yuiseki/exp-dodeca-earth/firmware/hub6_bench/README.md

# hub6_bench

XIAO ESP32-S3 1 枚と 74HC138 で、1.28 インチ丸型 LCD (GC9A01、Waveshare 1.28inch LCD Module) 6 枚を駆動するスケッチ。既定では、発注した基板 hub6_one (`hardware/hub6_one`) のピンの割り当てでビルドする。基板を発注する前に 6 枚を駆動できるかを確かめたブレッドボード (ピンの割り当ては hub6 の README と同じ) 用には、`HUB6_BREADBOARD` を定義してビルドする (下の「ビルドと書き込み」)。

## ビルドと書き込み

地球の画像 `earth_faces.h` は生成物で、git には入れていない。先に作る。元の画像は正距円筒の全球画像なら何でもよい。NASA Blue Marble 2002 (パブリックドメイン、exp-cubic-earth にある) なら:

```sh
../../.venv/bin/python make_earth_faces.py ../../../exp-cubic-earth/lt7680_earth/blue_marble_2002.jpg --preview earth.png
```

どのディスプレイがどの板に載っているかは `--board` で選ぶ。既定の `hub6_one` は、XIAO をお椀の口の側に向けて基板を裏返して使う置き方で、ケーブルの列が板に鏡の順で届く。底の外から見て P1〜P5 が反時計回りに並び、BASE の画面の上が P2 を向く (2026-11-05 に実物で確認)。`--board model` は 3D モデルの番号どおり (`make_earth_faces.py` の `PLACEMENT`)。

自前のタイルサーバーの地図 (Web メルカトルのラスタータイル) なら、ズーム 4 の 256 枚をつないで正距円筒に直してから使う。北緯 85 度より北と南緯 85 度より南はタイルに無いので、85 度の行の色を引き伸ばす:

```sh
../../.venv/bin/python make_tile_mosaic.py https://tile.yuiseki.net/styles/osm-liberty-no-text-no-icons --zoom 4 --cache ../../tmp/tiles --out ../../tmp/osm-liberty-equirect.png
../../.venv/bin/python make_earth_faces.py ../../tmp/osm-liberty-equirect.png --preview earth.png
```

そのあと、無線 (ESP-NOW) を使うなら `secrets.h` を作る。中身は exp-cubic-earth の `espnow_bridge/secrets.h` と同じ AP の並びにする (`secrets.h.example`、git には入れない)。無ければ AP にはつながず、ESP-NOW はチャンネル 1 で待つ:

```sh
cp ../../../exp-cubic-earth/espnow_bridge/secrets.h secrets.h
```

hub6_one rev E (草案) の基板には `--build-property "compiler.cpp.extra_flags=-DHUB6_ONE_REV_E"` を付けてビルドする。A0〜A2 のピン (D8、D9、D10) と、画面ごとのアドレスが rev D と違う。

テストは `../../.venv/bin/python -m pytest -q test_make_earth_faces.py test_board_matches_firmware.py` (後者は rev E の表が `hardware/hub6_one/make.py` と一致するか) と `g++ -std=c++17 -Wall -Wextra -I. test/test_espnow_cmd.cpp -o /tmp/t && /tmp/t` (`test_wifi_status.cpp`、`test_web_face.cpp` も同じ形で)。ビルドには PSRAM (`PSRAM=opi`) と、ライブラリ JPEGDEC (`arduino-cli lib install JPEGDEC`) が要る (`j` が PSRAM に 6 面を置き、JPEG を展開する)。

```sh
arduino-cli compile --fqbn esp32:esp32:XIAO_ESP32S3:PSRAM=opi --output-dir build .
arduino-cli upload --fqbn esp32:esp32:XIAO_ESP32S3:PSRAM=opi --input-dir build -p /dev/ttyACM0   # ポートは arduino-cli board list で
```

ブレッドボード用は、compile に `--build-property "compiler.cpp.extra_flags=-DHUB6_BREADBOARD"` を足す。

ライブラリは M5GFX (0.2.32 で確認。中の LovyanGFX の `Panel_GC9A01` を使う)。ESP32 の Arduino core は 3.3.12 で確認。

## 無線 (ESP-NOW)

母艦などに挿した exp-cubic-earth の `espnow_bridge` から、シリアルと同じ命令を送れる。起動して番号の画面を出したあと、`secrets.h` の AP (pi5-w-1 が先頭) につなぎ、ESP-NOW をその AP のチャンネルに相乗りさせる。中継も同じ並びで同じ AP につなぐので、チャンネルがそろう。起動のログに `wifi: pi5-w-1, channel 6` と `espnow: <MAC>, channel 6 (the AP's)` が出る。

中継に送る行と、受けるもの:

- `!E8:F6:0A:8D:28:D8 e`: この XIAO だけに送る。行全体を命令として受ける。ACK が返る
- `@dodeca e`: 全員に送る。正十二面体は `@dodeca ` のあとを命令として受ける
- `#b` などの四角い地球の命令: 全員に届くが、正十二面体は受けない。`#b` の `b` や `#f…` の `f` を自分の命令と取り違えないため (`espnow_cmd.h`)

命令の出力は、USB のシリアルに出すのに加えて、送り主にだけ 1 行ずつ返す。中継には `rx <MAC>: earth` のように出る。全員には送らない。

AP を待つのは 15 秒。pi5-w-1 は、鍵の交換から 3 秒後に IP を渡したことがあり、中継と同じ 8 秒では、その直前で諦めていた (2026-11-05)。

XIAO ESP32-S3 には基板のアンテナが無く、U.FL のアンテナを挿して使う。挿し忘れても ESP-NOW は近くならときどき届くので、気づきにくい。そのときのログは、スキャンで見える AP が 2〜4 個 (アンテナありなら 15 個ほど)、`wifi: joining pi5-w-1 (rssi 0 ...)` か `wifi: disconnected, reason 2` (認証の応答が来ない) の繰り返し、`wifi: no AP from secrets.h joined`。アンテナを挿すと rssi -60 前後でつながった (2026-11-05)。

AP につながらないあいだも、Wi-Fi は裏でつなぎ直そうとし続け、チャンネルを AP のもの (pi5-w-1 なら 6) に戻す。そのため `ESPNOW_CHANNEL` に合わせたつもりでも合っていないことがある。いまのチャンネルは `w` で聞ける (`wifi: no AP, channel 6 (asked for 1)`)。

## microSD (Sense の拡張基板)

カードの SCK、MISO、MOSI は D8、D9、D10 で、お椀の基板では 74HC138 の A2、A1、A0 と同じピン。CS だけ GPIO21 (拡張基板の R12)。四角い地球 (exp-cubic-earth) はこの 3 本を LT7680 と SPI のまま共有できるが、お椀ではアドレス線なので、カードに触るあいだだけ SPI に切り替え、終わったらアドレス出力に戻す (`cardTest`)。カードの通信中はアドレスが動いて、どれかの画面の CS が下がるが、画面の CLK (D4) と DIN (D5) は止まっているので何も書き込まれない、という見立て。カードは SPI3 (HSPI)、画面は SPI2。

カードなしで `c` を送ると `mount failed` が返り、そのあとも画面の命令は普通に通る (2026-11-07)。カードを入れると読み書きできた: 29.5GB の SDHC、115200 バイト (画面 1 枚ぶん) の書き込み 139 ms と読み 126 ms (10MHz)、90 ms と 79 ms (20MHz)、化けは 0 バイト。そのあとの `e` も通った (画面の見た目は未確認)。

## Web の地球 (`j`)

exp-cubic-earth の `#j` と同じく、Web サーバーに置いた JPEG を Wi-Fi で取って描く。microSD は要らない。

- 母艦で 6 面の JPEG を作る: `../../.venv/bin/python make_earth_faces.py <正距円筒図法の画像> --jpeg-dir <置き場> --name upper`。1 面 240 x 240、ベースライン JPEG (JPEGDEC はプログレッシブを展開しない)。並びは `earth_faces.h` と同じ (`--board`、`--cup`、`--fit` も同じ意味)
- 置き場の URL を `WEB_BASE` に (既定は exp-cubic-earth と同じ母艦の静的ファイルの下の `dodeca-earth`)。毎回 `?t=` を付けて取るので、前段のキャッシュが古い画像を返さない
- 1 面あたり 12〜30 KB。6 面で 145 KB を、取得と展開に約 3.9 秒、描くのに 0.3 秒 (HTTPS、pi5-w-1 経由、2026-11-07)
- その日の衛星画像 (NASA GIBS の VIIRS) は、軌道の隙間と極夜が黒く抜け、日によっては広い範囲がまるごと欠ける (2026-11-06 は東アジアの 99%)。新しい日から順に重ね、まだ黒いところだけを 1 日前、2 日前の画像で埋め、最後に残った極夜をブルーマーブルで埋める。11-06、05、04 の 3 日で欠けは 31% から 15% (ほぼ極夜だけ) になった。ブルーマーブルだけで埋めると、そこだけ雲が無くなる

## hub6_one の割り当て

基板の配線で決まっている (`hardware/hub6_one/make.py` の `XIAO_NETS` と `CS_OUTPUT`)。

| 信号 | XIAO |
|---|---|
| DIN | D5 |
| CLK | D4 |
| DC | D3 |
| RST | D2 |
| BL | D1 |
| 74HC138 の A0、A1、A2 | D10、D9、D8 |

| ディスプレイ | 74HC138 の出力 | アドレス |
|---|---|---|
| P1 | 13 (Y2) | 2 |
| P2 | 14 (Y1) | 1 |
| P3 | 15 (Y0) | 0 |
| P4 | 10 (Y5) | 5 |
| P5 | 12 (Y3) | 3 |
| BASE | 11 (Y4) | 4 |

Y6 と Y7 は何にもつながっていない。アドレス 7 で、どの画面も選ばない。XIAO の D0、D6、D7 は使わない。

## ブレッドボードの配線

電源はすべて XIAO の 3V3 から取る (ディスプレイの VCC は 3.3V。理由は hub6 の README)。XIAO の 5V は使わない。

### XIAO と 74HC138 (TC74HC138AP などの DIP-16)

| XIAO | 74HC138 | 意味 |
|---|---|---|
| D7 | 1 (A) | A0 |
| D8 | 2 (B) | A1 |
| D9 | 3 (C) | A2 |
| GND | 4 (G2A)、5 (G2B)、8 (GND) | 常に有効 |
| 3V3 | 6 (G1)、16 (VCC) | 常に有効、電源 |

74HC138 の 16 番と 8 番の間に、0.1uF のコンデンサを 1 個入れる (基板の C3 と同じ)。

### ディスプレイ (付属の PH2.0 と Dupont のケーブル)

6 枚とも同じ線を共有する。ブレッドボードで、信号ごとに 1 列を作り、XIAO と 6 枚をその列につなぐ。

| ディスプレイの線 | 付属ケーブルの色 | つなぐ先 |
|---|---|---|
| VCC | 紫 | XIAO 3V3 |
| GND | 白 | XIAO GND |
| DIN | 緑 | XIAO D0 |
| CLK | オレンジ | XIAO D1 |
| CS | 黄 | 74HC138 の出力 (下の表) |
| DC | 青 | XIAO D3 |
| RST | 茶 | XIAO D4 |
| BL | 灰 | XIAO D5 |

色は、ディスプレイに付属の PH2.0 と Dupont のケーブルのもの (2026-10-21 に実物で確かめた)。hub6 の基板に使う「PH2.0 とより線」のケーブル (Amazon) の色は、これと同じとは限らない。

| ディスプレイ | CS をつなぐ 74HC138 のピン | アドレス |
|---|---|---|
| P1 | 15 (Y0) | 0 |
| P2 | 14 (Y1) | 1 |
| P3 | 13 (Y2) | 2 |
| P4 | 12 (Y3) | 3 |
| P5 | 10 (Y5) | 5 |
| BASE | 11 (Y4) | 4 |

P5 と BASE が入れ替わって見えるのは、基板の配線の都合 (hub6 の README の表と同じ)。74HC138 の 9 番 (Y6) と 7 番 (Y7) は何にもつながない。

XIAO の D2、D6、D10 は使わない。

## 動き

1. 電源を入れると、6 枚を 1 回だけリセットし、1 枚ずつ初期化する
2. 各ディスプレイが自分の名前、アドレス、色を表示して止まる (P1 赤、P2 緑、P3 青、P4 黄、P5 マゼンタ、BASE シアン)。組み立てと配線の確かめのあいだは、この画面のほうが、どの画面がどれかを読みやすい
3. シリアルで `e` を送ると、各ディスプレイに、その面が受け持つ地球の一部を表示して止まる。球の中心から見た形 (心射図法)。既定では、お椀を上半球として描き、BASE が北極、P2 の中心が東京の経度 (`make_earth_faces.py` の `--cup`、`--face`、`--lon` で変えられる)

`make_earth_faces.py` の `--fit` で、1 枚に入れる範囲を選ぶ:

- `edge` (既定): 面の中心から辺までを、画面の円に縮めて入れる。隣の画面とは辺の真ん中で絵がつながり、欠けるのは五角形の角の近くだけ。中心から辺までは 31.7 度
- `window`: 球の中心から画面を窓としてのぞいたときに見える範囲を、縮尺どおりに出す。画面は面より小さく、中心から 23 度ほどしか映らないので、地球の約半分が画面と画面の間に落ちる (北アメリカの大半、カナダ、ロッキー山脈など)

塗りつぶしの試験 (`b`) では、6 枚を順に全面塗りつぶし続ける。自分の色と黒が 1 秒に約 6 回ずつ入れ替わる (わざと点滅させている)。真ん中に名前が出る。シリアル (115200) に、2 秒ごとに「1 秒に何回、6 枚ぶんを描けたか」が出る

シリアルの命令:

| 命令 | 意味 |
|---|---|
| `i` | 名前の表示 (2 の画面、起動したときの画面) にして止める |
| `e` | 地球の表示 (3 の画面) にして止める |
| `b` | 塗りつぶしの試験 |
| `c 10` | Sense の拡張基板の microSD を読む (種類、大きさ、根の一覧)。書き込みはしない。カードがなければ `card: mount failed`。MHz は省くと 10 |
| `cw 20` | 上に加えて、`/dodeca_test.bin` (115200 バイト、画面 1 枚ぶん) を書いて読み返し、消して、速さを測る。他の用途のカードには使わない |
| `j upper` | Web の 6 面を取って描く (`WEB_BASE/<名前>-P1.jpg` 〜 `-BASE.jpg`、名前を省くと upper)。6 面とも取れたときだけ描き替え、1 面でも失敗したら前のまま。取った面は PSRAM に置き、`e` か再起動で焼き込みの地球に戻る。Wi-Fi が要る |
| `w` | 無線の状態を 1 行で返す。AP につながっていれば AP の名前、チャンネル、受信の強さ (rssi)、IP。つながっていなければ、いまのチャンネルと、ファームが合わせようとしたチャンネル (`ESPNOW_CHANNEL`)。どちらも起動からの秒数つき |
| `f 20` | SPI のクロックを 20MHz にする (80、40、27、20、16、10 から選ぶ)。保存して再起動する。既定は 20MHz (ブレッドボードで 6 枚が安定した上限) |

## 確かめること

- 名前の表示で、6 枚とも正しい名前と色が出るか。名前が違う画面に出たら、CS の配線か、アドレスの選び方の誤り。赤のはずが水色などになったら、色の反転の設定 (`invert`) か、色の並び (`rgb_order`) の誤り
- 塗りつぶしの試験で、画面に乱れ (縞、ずれ、ほかの画面の内容) が出ないか
- 何回/秒出るか。40MHz で約 7 回/秒が計算上の値 (240 x 240 x 2 バイト x 6 枚を、40MHz で送る)
- 10 分ほど回したあとの、XIAO のレギュレーターの温度 (指で触れられないほど熱くないか)
- Dupont の 23cm のケーブルは、基板で使う長さより長い。40MHz で乱れたら、20MHz でも試して、両方の結果を残す

## 試した結果 (2026-10-21、ブレッドボード、付属の 23cm の Dupont 線)

- 74HC138 で 6 枚を選び分けて、それぞれ別の画像 (地球、地図) を描けた
- SPI のクロックは 20MHz まで安定。27MHz と 40MHz では、起動するたびに違う 1〜2 枚が真っ黒になったり、縦筋やノイズが出たりした。4 枚までは 40MHz でも映った。初期化をやり直すと直る画面と直らない画面があり、電源の電圧より、信号の波形の崩れで説明できる (各ディスプレイの TXB0108 は、切り替わりの瞬間に自分から押し出す仕組みがあり、長い配線や 1 本の線に何個もつなぐ使い方に向かない)。基板では配線が短くなるので、上限が上がるかは基板で確かめる
- 20MHz で、6 枚の全画面の塗りつぶしは 3.2 回/秒 (計算上の上限 3.6 回/秒)
- 6 枚を 10 分間描き続けても、XIAO のレギュレーターの熱は指で気付かない程度
- はまったこと: LovyanGFX は、最後に送った描画範囲 (CASET、RASET) を覚えていて、次が同じ範囲なら送らない。1 つの `lcd` で 6 枚を切り替えると、2 枚目からは範囲が届かず、画像が小さな範囲に流れ込んで、画面が変わらないように見えた。画面を選ぶたびに、覚えている範囲を忘れさせる (`forgetWindow()`)
