yuiseki/exp-dodeca-earth/3d/pentagon/constrains.md

# 筐体 (正十二面体のお椀) の制約

お椀の大きさと、画面 (1.28 インチの丸型 LCD モジュール) の付け方を決めるための制約と、計算で分かったこと。目的は、画面と画面の間の白い余白を減らすこと。

数字は `simulate/module_fit/` のスクリプトで再現できる (末尾)。

## 何がジレンマか

- 正十二面体の面は、外へ行くほど広がる。画面を板から高く浮かせるほど、隣の画面と当たらずに、お椀全体を小さくできる (正面から見た白い余白が減る)
- しかし、浮かせるほど、画面の下に隙間ができ、斜めから見ると白い板が見える
- 逆に、板に穴を空けて画面を沈めると、横から見た隙間は消えるが、隣の画面と当たるので、お椀を大きくしないといけない (正面から見た余白が増える)

## 画面のモジュール (Waveshare 1.28inch LCD Module)

`3d/display/1.28inch_LCD_Module_3D_Drawing/.../0508.stl` から測った。

| 部分 | 寸法 |
|---|---|
| 基板 (PCB) | 丸の直径 37.5 mm。一方向に出っ張り (台座) があり、丸の中心から 21.7 mm まで。出っ張りは丸から 2.95 mm 出て、幅は約 14 mm |
| ガラスと表示の層 | 丸の直径 35.5 mm。出っ張りの側は中心から 20.7 mm まで (LCD の FPC がある側) |
| 表示の範囲 | 直径 32.4 mm (240 x 240 画素) |
| 高さ | 基板の裏を板の外側の面 (z = 0) に置くと、基板が 0 から 1.6 mm、ガラスが 1.6 から 3.75 mm |
| 裏の部品と PH2.0 コネクタ | 基板の裏に、高さ約 5.45 mm まで。コネクタは出っ張りの反対側。板の穴を通って、お椀の中に入る |
| 取り付け穴 | モジュールの中心から (±13.35, ±9.3) mm の 4 か所。板の穴は直径 3.8 mm (3.5 mm のスペーサーが通る) |

## 正十二面体の幾何 (辺 L)

| 量 | 式 | L = 30 mm |
|---|---|---|
| 中心から面まで (内接球の半径) | 1.1135 L | 33.41 mm |
| 面の中心から辺まで | 0.6882 L | 20.65 mm |
| 面の中心から頂点まで | 0.8507 L | 25.52 mm |
| 隣り合う面の角 | 116.565 度 | |
| 面の外への広がり | 外へ 1 mm 出るごとに、辺まで 1/φ = 0.618 mm 増える | |
| お椀の内側の壁 | 深さ 1 mm ごとに、辺まで 0.5 mm 狭まる (v0.0.5 の STL を輪切りにして測った) | |

## 制約

### 外側 (画面)

1. 隣り合う面の画面 (基板とガラスの立体) どうしが当たらない。間隔 0.3 mm を取る。当たる相手は、底と側面、側面どうし、上下のお椀の側面どうし
2. モジュールの取り付け穴が、自分の板の上にある (穴の中心から板の縁まで 2.7 mm 以上: 穴の半径 1.9 mm + 壁 0.8 mm)
3. 裏のコネクタの穴が、自分の板の中にある (縁から 0.8 mm 以上)
4. 板に穴を空けて沈める場合は、板の外側の面に、穴のまわりの縁が残る (0.3 mm 以上)。残らないと、穴が隣の板まで突き抜ける

### 板とお椀 (v0.0.4、v0.0.5 から)

5. 板は 2 mm 厚で、厚くできない。面取りが 1 mm の厚さごとに 1/φ mm 食い込み、頂点の近くのねじ穴とコネクタの穴の角が、縁から約 2 mm しかないため
6. お椀の縁 (上下のお椀の境目) には、磁石 (直径 3 mm x 1 mm、お椀あたり 20 個) の出っ張り (ボス、7.5 x 6.5 mm、最大 5.5 mm 厚) が、側面の板の頂点と角にある。穴を空ける案では、穴がボスと磁石の穴に近づく
7. 上のお椀は、下のお椀を x 軸のまわりに 180 度回したもの。1 つの設計で両方を刷るには、画面の向きや穴が、この回転で重なる必要がある

### 内側 (お椀の中)

8. 基板 (hub6_one) が入る。rev E は辺まで 22.4 mm で、壁の傾きから、いまのお椀では基板を約 7.2 mm 深く沈められる計算。お椀を小さくすると、この余裕が減る (辺 30 mm から 28.75 mm で、粗く 1.5 mm 減る)
9. XIAO の高さ。素の XIAO ESP32-S3 に対し、Sense の拡張基板だけで約 +4.3 mm、カメラつきで約 +9.5 mm (STEP から)。ソケットは 8.5 mm から 5.0 mm に低くできる (C27985232)
10. 底の画面の PH2.0 プラグの高さ (基板を沈められる深さの下限)。まだ測っていない
11. ケーブルは 15 cm、基板の穴に手はんだ。穴の間隔は 2.54 mm 以上 (rev E の側面は 2.8 mm)

### 見え方 (人の判断)

12. 発色と解像感は良い。白い余白が多すぎるのが課題 (2026-11-07、本人の目視)
13. 出っ張り (切れ目) は、赤道の側にあるほうが自然に見えるのではないか (本人の直感、まだ確かめていない)
14. 側面の画面を 180 度回すと、絵も 180 度回す必要がある (ファームか `make_earth_faces.py`)

### 作り方

15. JLCPCB の 3D 印刷。費用は体積で決まり、同じ STL を何個も頼む (exp-cubic-earth の経験)。壁は 0.8 mm 以上を目安にしている

## 計算の結果

制約 1 から 3 (沈める場合は 4 も) を満たす、いちばん小さい辺。画面の中心は、面の中心から出っ張りの向きにずらして探した (側面は -3 から +3 mm、底は `fit.py` では -1 から +1 mm、`fit_recessed.py` では -3 から +3 mm)。

| 画面の高さ | 出っ張りを極の側 (いまの向き) | 出っ張りを赤道の側 |
|---|---|---|
| 1.6 mm 沈める (縁の条件 4 あり) | 31.00 mm | 31.00 mm |
| 1.6 mm 沈める (縁の条件なし、突き抜けを許す) | 31.00 mm | 30.25 mm |
| いまの付け方 (板の上に置く) | 30.00 mm | 28.75 mm |
| さらに 2 mm 浮かせる | (未計算) | 27.75 mm |
| さらに 4 mm 浮かせる | (未計算) | 26.75 mm |

- いまの付け方で、出っ張りが極の側だと、側面の 5 枚の出っ張りが底の画面に当たり、30.00 mm が限界になる。赤道の側に向けると、この当たりが無くなり、28.75 mm まで行ける。その先は、底と側面の当たりと、取り付け穴が板からはみ出すことの両方で決まる。取り付け穴の条件を外しても 28.75 mm のままだった
- 平面 (五角形に、丸と出っ張りを入れる) だけで見ると、出っ張りの向きでほとんど差が無い (辺に向けて 29.30 mm、頂点に向けて 29.67 mm)。差が出るのは、面どうしが傾いている立体で見たとき
- いまの筐体 (辺 30 mm、出っ張りは極の側) は、いまの付け方での限界ちょうど

## 全パターンの計算 (`simulate/module_fit/sweep.py`)

側面の出っ張りの向き (赤道の頂点から 12 度ごと、0 から 180 度)、底の出っ張りの向き (辺 / 頂点)、画面の高さ (-1.6 mm と、0 から +4 mm を 0.5 mm ごと) の 320 通りで、最小の辺を 0.125 mm まで求めた (2026-11-07)。表と絵は `tmp/simulate/` (git に入れない)。

主な結果 (最小の辺、mm):

| 側面の向き | 底の向き | -1.6 | 0 | +1 | +2 | +3 | +4 |
|---|---|---|---|---|---|---|---|
| 0 (赤道の頂点) | 頂点 | 29.69 | 28.28 | 27.34 | 26.97 | 26.41 | 26.31 |
| 0 (赤道の頂点) | 辺 | 30.16 | 28.75 | 27.91 | 27.62 | 27.06 | 26.69 |
| 72 (横の頂点) | 頂点 | 29.78 | 28.38 | 27.44 | 26.97 | 26.41 | 26.31 |
| 108 (横の辺) | 頂点 | 29.88 | 28.38 | 27.53 | 26.59 | 26.31 | 26.31 |
| 36 (赤道寄りの辺) | 頂点 | 30.91 | 29.50 | 29.31 | 28.75 | 28.28 | 28.09 |
| 180 (極の辺、いまの向き) | 辺 | 31.19 | 29.78 | 29.31 | 28.75 | 28.56 | 28.09 |

- いまの高さでは、側面の出っ張りを赤道の頂点 (0 度) に、底の出っ張りを頂点に向けた組が最小 (28.28 mm、いまより 5.7% 小さい)。横の頂点 (72 度) や横の辺 (108 度) も 28.38 mm で近い
- 側面の出っ張りを、底の画面に近い向き (極の辺 180 度、その両隣) や、赤道寄りの辺 (24 から 48 度) に向けると不利 (29.5 から 30 mm)
- 底の出っ張りは、辺より頂点に向けるほうが 0.4 から 0.5 mm 有利
- 浮かせると小さくなるが、+3 mm 前後から 26.3 mm 付近で止まる。そこでは、取り付け穴が板からはみ出すこと (制約 2) が限界
- 沈める (-1.6 mm) と、どの向きでも 29.7 mm 以上

### 画面を五角形に収める場合 (`sweep.py ... contain`)

画面のモジュールの外形 (基板と出っ張り、面に投影したもの) が自分の面の正五角形からはみ出さない、という条件を足すと、320 通りすべてで、この条件が限界になった。最小の辺は 29.97 から 30.44 mm で、いまの高さ以上では、向きでも高さでもほぼ変わらない (浮かせても、面に投影した平面の広さは変わらないため)。いまの筐体 (辺 30 mm) は、この条件ではほぼ最小。

この計算は、画面を出っ張りの方向にだけ 0.5 mm 刻みでずらしている。ずらし方を自由にした平面だけの計算では 29.21 から 29.67 mm (出っ張りを辺と頂点の中間に向けたときが最小)。最適にずらしても、縮むのは 1 mm 未満。

画面を五角形に収めたまま、お椀を小さくして白い余白を減らすことは、ほとんどできない。丸は内接円いっぱいでも五角形の面積の 86.5% しか覆えず、さらにモジュールの基板の縁 (表示の範囲の外) の分の余白が加わる。

北極 (底と天) の画面だけは五角形からはみ出してよいとしても、北極の画面を無くしても、最小の辺は 29.41 から 29.88 mm で、ほとんど縮まない (`base_exempt.py`)。限界は、側面の画面が自分の五角形に収まることそのもの。

丸い部分 (基板の直径 37.5 mm) だけを五角形に収め、出っ張りは赤道の側も極の側もはみ出してよいとすると、側面の出っ張りを赤道の頂点、北極の出っ張りを頂点に向けた組で、いまの高さ 28.56 mm、+1 mm で 27.81 mm、+2 mm 以上で 27.62 mm (`round_contained.py`)。限界は丸が五角形に収まること (丸だけの平面の限界は 27.25 mm)。出っ張りどうしの当たりは、この高さでは限界にならない。北極の出っ張りまで収めると 30.16 mm (底の出っ張りを辺に向けて 29.97 mm) で、ほとんど縮まない。

## まだ分かっていないこと

- 底の画面のプラグの高さ (制約 10)
- 浮かせた画面の下の隙間が、どの角度からどれくらい見えるか。白い板を黒くするなど、見えても目立たなくする手も含めて
- 出っ張りを赤道の側にしたときの見え方 (制約 13)
- 磁石のボスが、詰めた大きさで入るか (制約 6)

## 再現

```bash
cd simulate/module_fit
../../.venv/bin/python fit.py                       # 2 つの向きで、いまの付け方の最小の辺 (約 10 分)
../../.venv/bin/python fit_recessed.py 2 0.3 1.6    # 赤道の側、縁 0.3 mm、1.6 mm 沈める
../../.venv/bin/python fit_recessed.py 2 -100 -2    # 赤道の側、縁の条件なし、2 mm 浮かせる
../../.venv/bin/python render.py                    # 2 つのパターンを最小の大きさで絵にする (patterns.png)
```
