yuiseki/exp-dodeca-earth/simulate/v0.0.5/cables.png

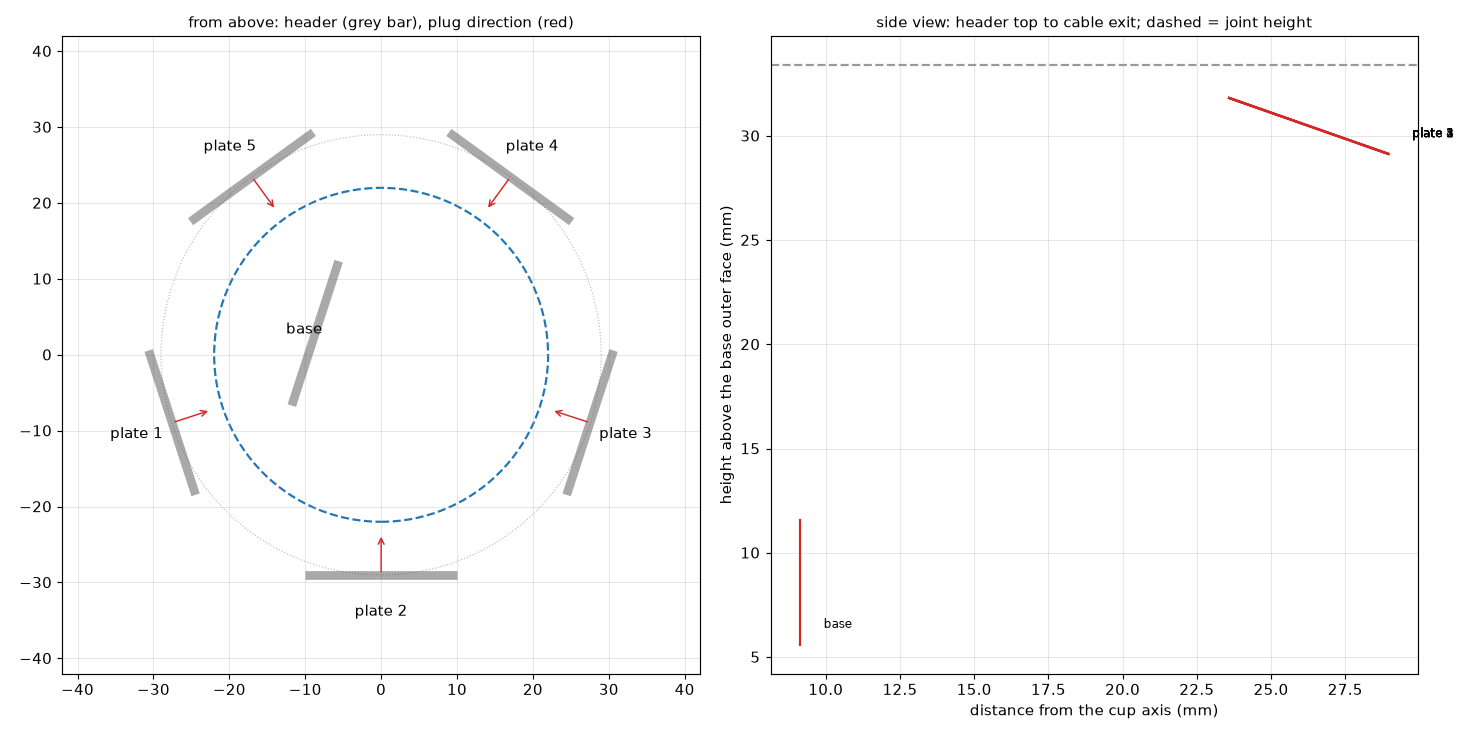
simulate/v0.0.5/cables.png
