yuiseki/exp-dodeca-earth/simulate/v0.0.5/magnets.png

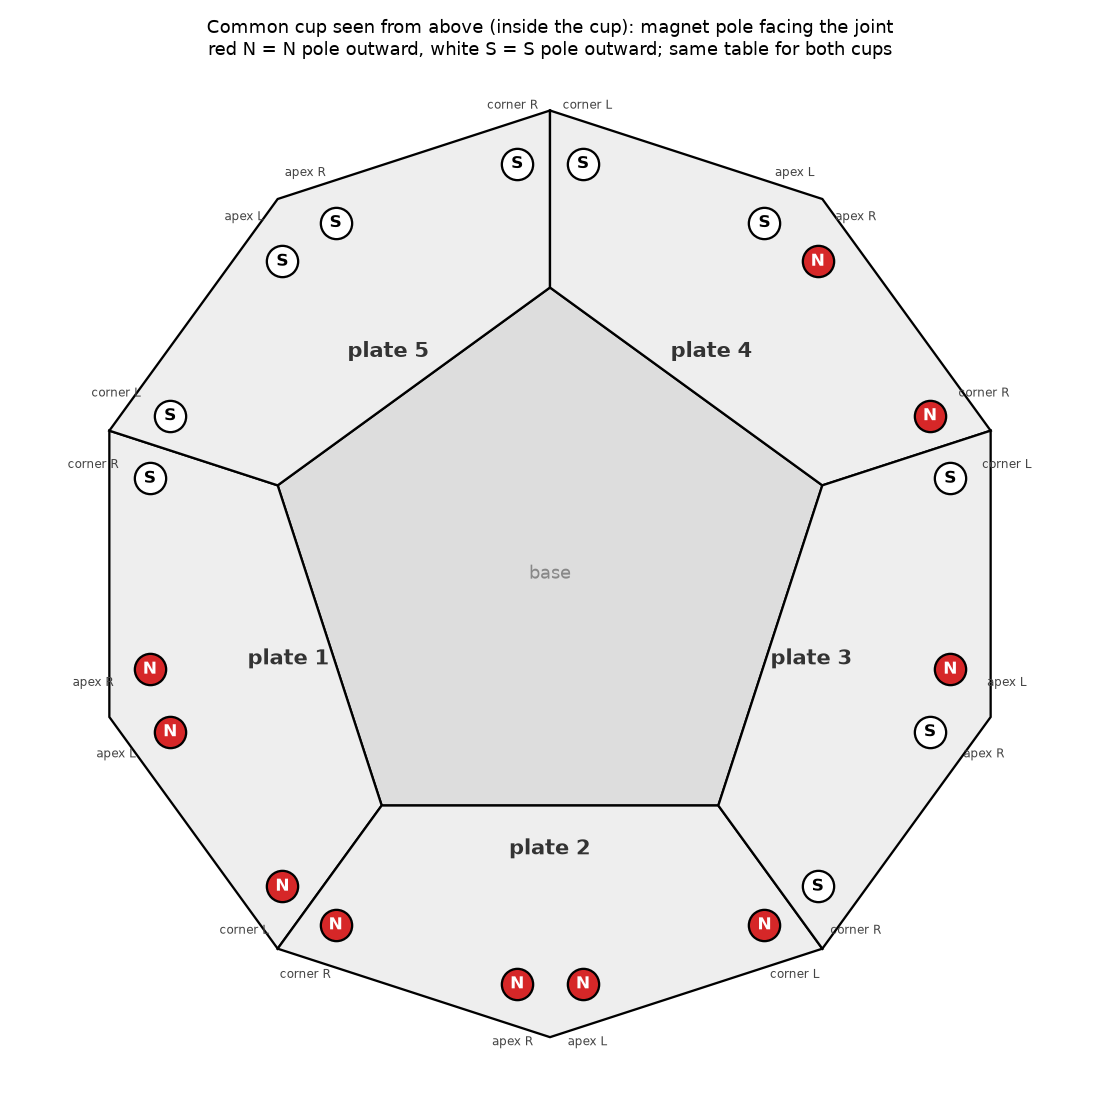
simulate/v0.0.5/magnets.png
