yuiseki/exp-dodeca-earth/hardware/hub6_one/fab6/hub6_one-bom.csv

Comment | Designator | Footprint | LCSC Part #
10uF | C2 | C_0805_2012Metric | C15850
100nF | C3 | C_0603_1608Metric | C14663
PinSocket_1x07_P2.54mm_Vertical | J7,J8 | PinSocket_1x07_P2.54mm_Vertical | C27985232
74HC138 | U1 | SOIC-16_3.9x9.9mm_P1.27mm | C2674688
