yuiseki/exp-dodeca-earth/3d/pentagon/v0.0.6-a/lcd_pentagon_plate_pole.step

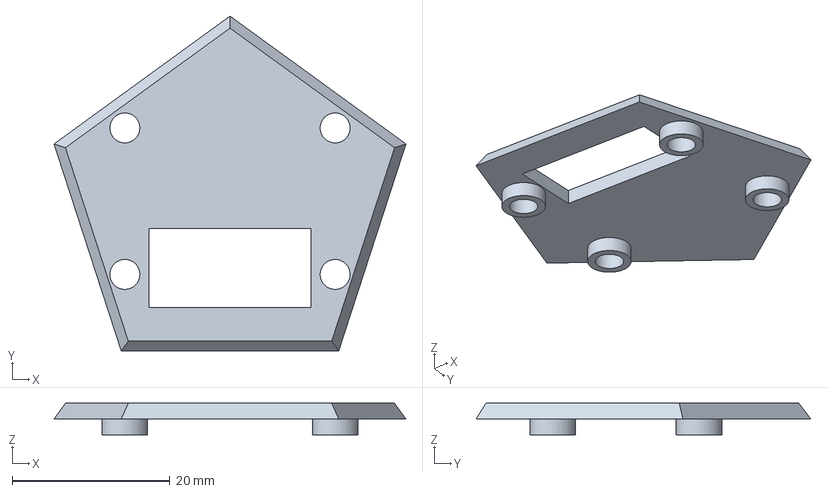
[picture p3: CAD file, 2026-11-07]
3d/pentagon/v0.0.6-a/lcd_pentagon_plate_pole.step
44.7 x 42.5 x 4.00 mm
