yuiseki/exp-dodeca-earth/3d/pentagon/v0.0.6-b/lcd_pentagon_plate_pole.step

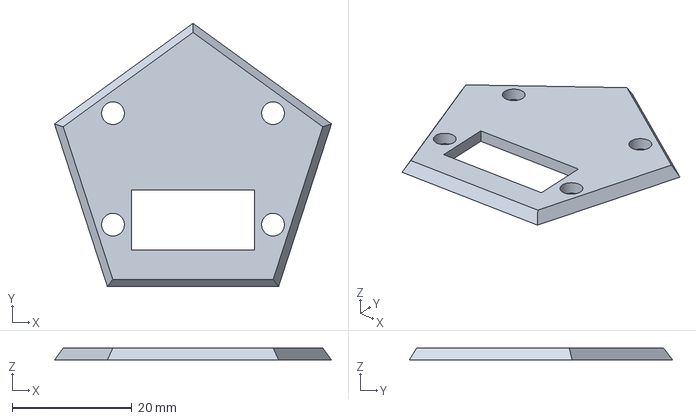
[picture p4: CAD file, 2026-11-07]
3d/pentagon/v0.0.6-b/lcd_pentagon_plate_pole.step
46.2 x 44.0 x 2.00 mm
