yuiseki/exp-dodeca-earth/3d/pentagon/v0.0.6-a/lcd_pentagon_plate_side.step

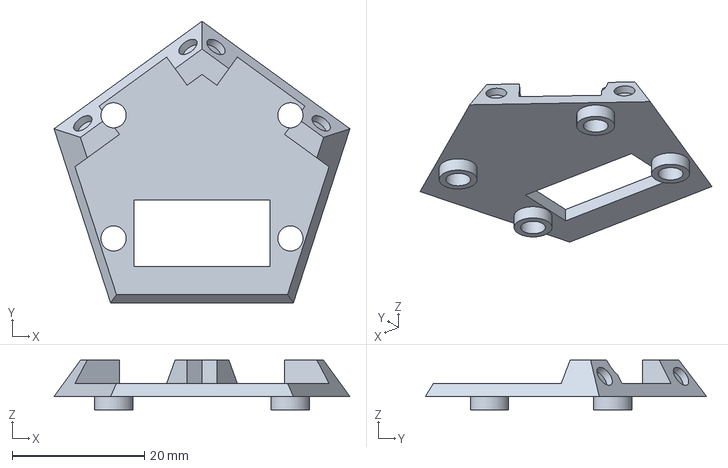
[picture p5: CAD file, 2026-11-07]
3d/pentagon/v0.0.6-a/lcd_pentagon_plate_side.step
44.7 x 42.5 x 7.50 mm
