yuiseki/exp-dodeca-earth/3d/pentagon/v0.0.6-b/lcd_cup.step

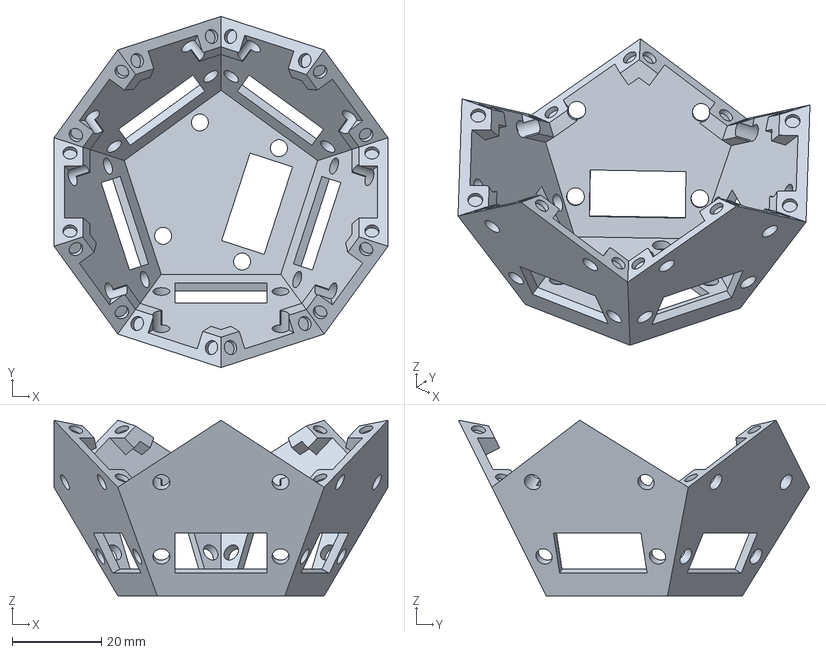
[picture p6: CAD file, 2026-11-07]
3d/pentagon/v0.0.6-b/lcd_cup.step
74.8 x 78.6 x 39.3 mm
