yuiseki/exp-dodeca-earth/3d/pentagon/v0.0.6-a/lcd_cup.step

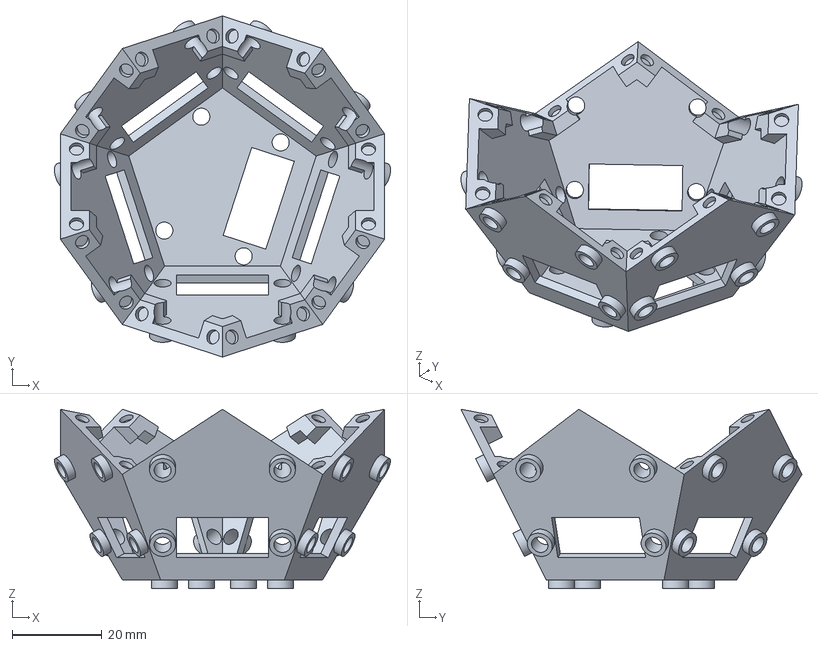
[picture p7: CAD file, 2026-11-07]
3d/pentagon/v0.0.6-a/lcd_cup.step
74.9 x 76.0 x 40.0 mm
