yuiseki/exp-dodeca-earth/3d/pentagon/v0.0.6-b/lcd_pentagon_plate_side.step

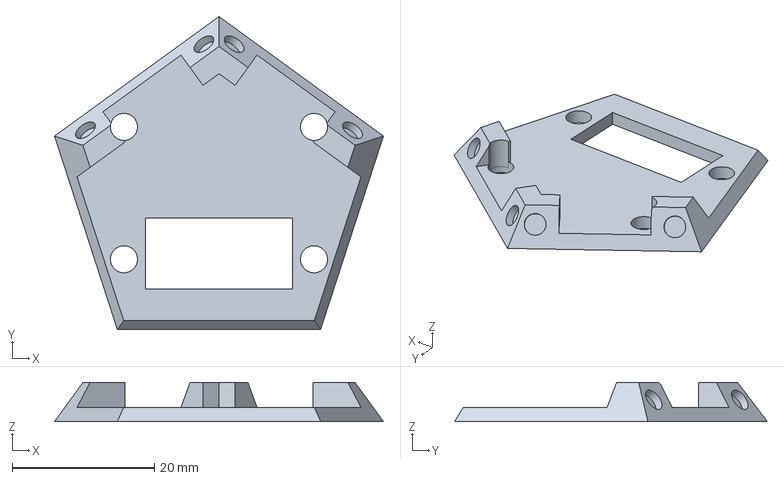
[picture p8: CAD file, 2026-11-07]
3d/pentagon/v0.0.6-b/lcd_pentagon_plate_side.step
46.2 x 44.0 x 5.50 mm
