yuiseki/exp-dodeca-earth/3d/pentagon/v0.0.1/lcd_pentagon_plate.step

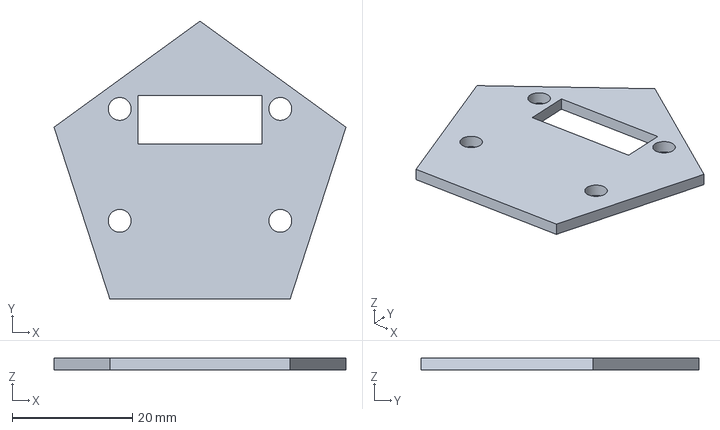
[picture p9: CAD file, 2026-10-09, an earlier design]
3d/pentagon/v0.0.1/lcd_pentagon_plate.step
48.5 x 46.2 x 2.00 mm
