yuiseki/exp-dodeca-earth/3d/pentagon/v0.0.4/lcd_pentagon_plate_upper.step

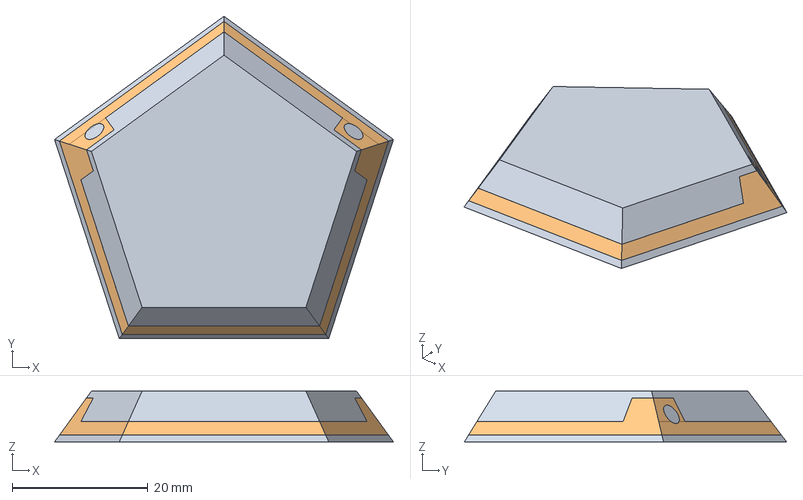
[picture p11: CAD file, 2026-10-09, an earlier design]
3d/pentagon/v0.0.4/lcd_pentagon_plate_upper.step
50.0 x 47.5 x 7.50 mm
