yuiseki/exp-dodeca-earth/3d/pentagon/v0.0.5/lcd_cup.step

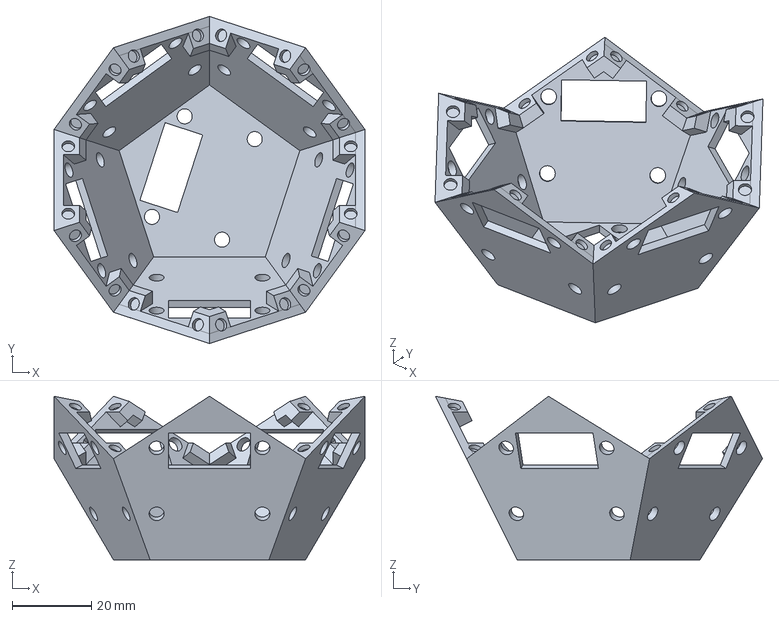
[picture p12: CAD file, 2026-10-10, an earlier design]
3d/pentagon/v0.0.5/lcd_cup.step
78.5 x 82.6 x 41.3 mm
