yuiseki/exp-dodeca-earth/3d/pentagon/v0.0.4/lcd_pentagon_plate_cap.step

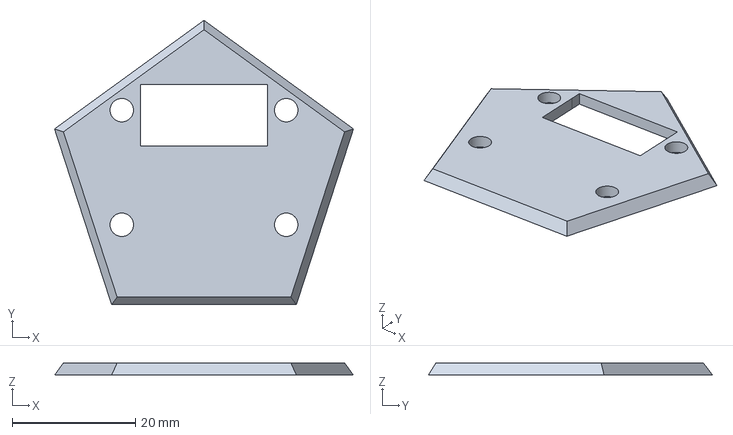
[picture p13: CAD file, 2026-10-09, an earlier design]
3d/pentagon/v0.0.4/lcd_pentagon_plate_cap.step
48.5 x 46.2 x 2.00 mm
