yuiseki/exp-dodeca-earth/(list of files, cad)

Other CAD files:
3d/pentagon/v0.0.6-b/lcd_pentagon_plate_side_plain.step
3d/pentagon/v0.0.6-a/lcd_pentagon_plate_side_plain.step
3d/pentagon/v0.0.4/lcd_pentagon_plate_lower.step
3d/pentagon/v0.0.5/lcd_pentagon_plate_side.step
3d/pentagon/v0.0.1/lcd_pentagon_plate.stl
3d/pentagon/v0.0.2/lcd_pentagon_plate.stl
3d/pentagon/v0.0.4/lcd_pentagon_plate_cap.stl
3d/pentagon/v0.0.4/lcd_pentagon_plate_lower.stl
3d/pentagon/v0.0.4/lcd_pentagon_plate_upper.stl
3d/pentagon/v0.0.5/lcd_cup.stl
3d/pentagon/v0.0.5/lcd_pentagon_plate_side.stl
3d/pentagon/v0.0.6-a/lcd_cup.stl
3d/pentagon/v0.0.6-a/lcd_pentagon_plate_pole.stl
3d/pentagon/v0.0.6-a/lcd_pentagon_plate_side.stl
3d/pentagon/v0.0.6-a/lcd_pentagon_plate_side_plain.stl
3d/pentagon/v0.0.6-b/lcd_cup.stl
3d/pentagon/v0.0.6-b/lcd_pentagon_plate_pole.stl
3d/pentagon/v0.0.6-b/lcd_pentagon_plate_side.stl
3d/pentagon/v0.0.6-b/lcd_pentagon_plate_side_plain.stl
