yuiseki/exp-dodeca-earth/hardware/hub6/build/top.png

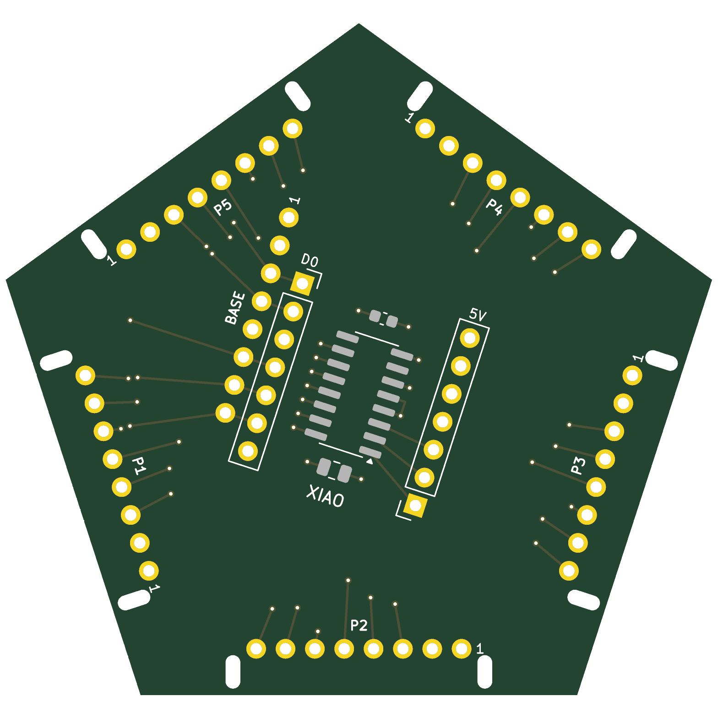
hardware/hub6/build/top.png
