yuiseki/exp-dodeca-earth/hardware/hub6_one/hub6_one.kicad_pcb

## KiCad design hardware/hub6_one/hub6_one.kicad_pcb (2026-11-07)

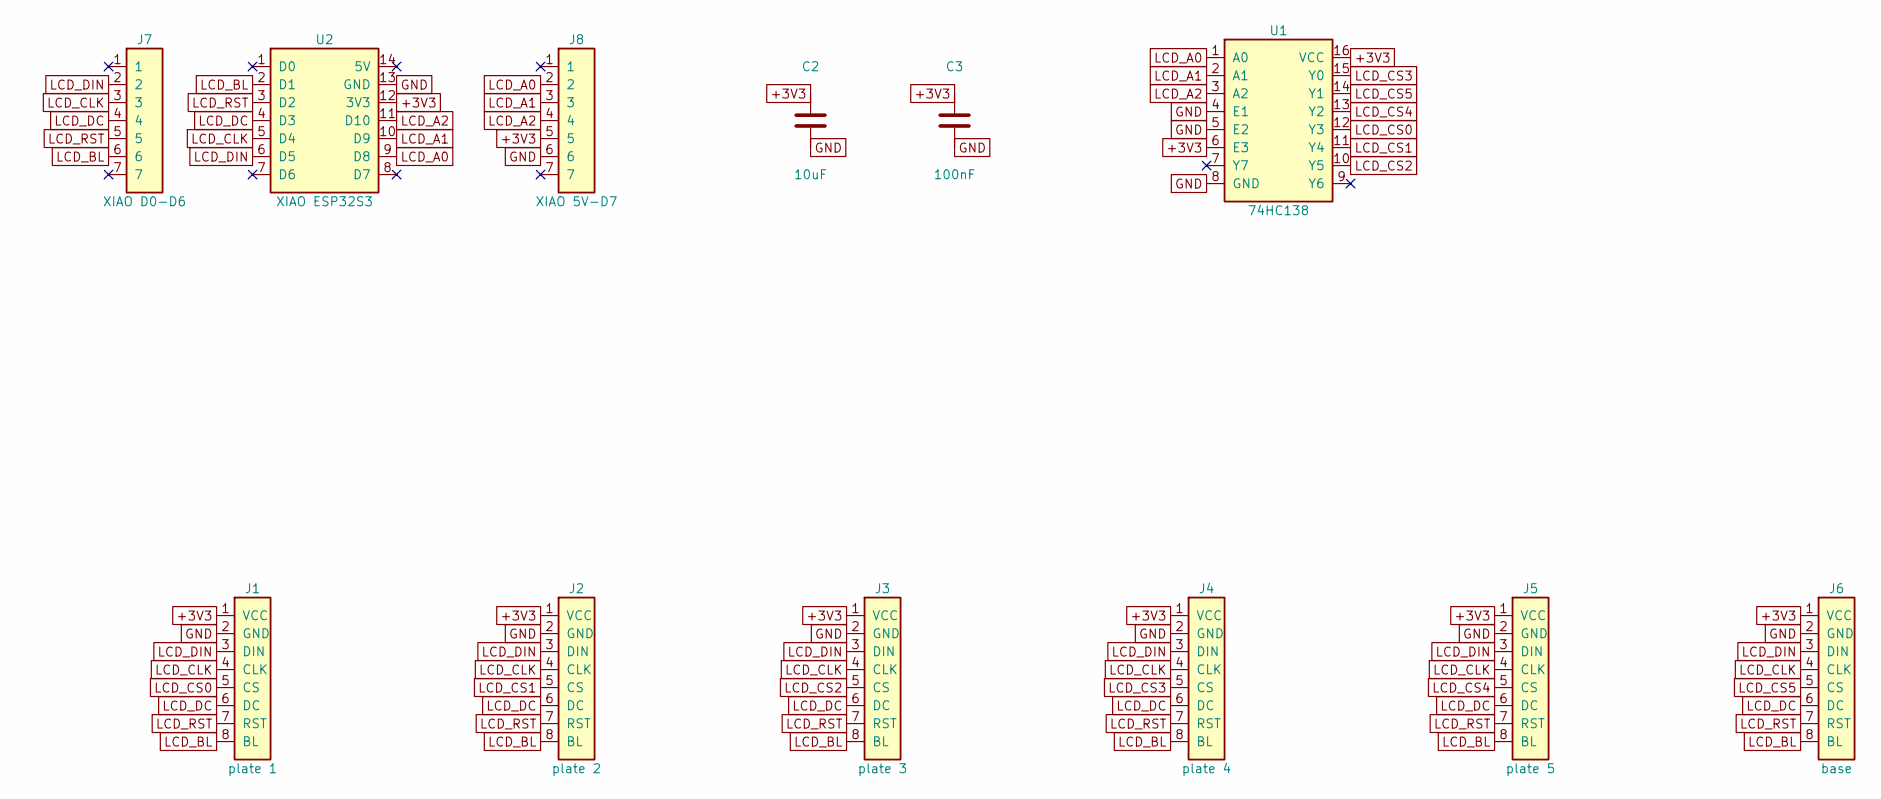
[picture p15: schematic hub6_one.kicad_sch, dodecahedron-earth hub6_one]

Parts:
C2: 10uF; C_0805_2012Metric; LCSC C15850
C3: 100nF; C_0603_1608Metric; LCSC C14663
J1: plate 1; Wire_1x08_P2.80
J2: plate 2; Wire_1x08_P2.80
J3: plate 3; Wire_1x08_P2.80
J4: plate 4; Wire_1x08_P2.80
J5: plate 5; Wire_1x08_P2.80
J6: base; Wire_2x04_P2.54
J7: XIAO D0-D6; PinSocket_1x07_P2.54mm_Vertical; LCSC C27985232
J8: XIAO 5V-D7; PinSocket_1x07_P2.54mm_Vertical; LCSC C27985232
U1: 74HC138; SOIC-16_3.9x9.9mm_P1.27mm; LCSC C2674688
U2: XIAO ESP32S3

Connections:
+3V3: C2.1, C3.1, J1.1 (VCC), J2.1 (VCC), J3.1 (VCC), J4.1 (VCC), J5.1 (VCC), J6.1 (VCC), J8.5, U1.6 (E3), U1.16 (VCC), U2.12 (3V3)
GND: C2.2, C3.2, J1.2 (GND), J2.2 (GND), J3.2 (GND), J4.2 (GND), J5.2 (GND), J6.2 (GND), J8.6, U1.4 (E1), U1.5 (E2), U1.8 (GND), U2.13 (GND)
LCD_A0: J8.2, U1.1 (A0), U2.9 (D8)
LCD_A1: J8.3, U1.2 (A1), U2.10 (D9)
LCD_A2: J8.4, U1.3 (A2), U2.11 (D10)
LCD_BL: J1.8 (BL), J2.8 (BL), J3.8 (BL), J4.8 (BL), J5.8 (BL), J6.8 (BL), J7.6, U2.2 (D1)
LCD_CLK: J1.4 (CLK), J2.4 (CLK), J3.4 (CLK), J4.4 (CLK), J5.4 (CLK), J6.4 (CLK), J7.3, U2.5 (D4)
LCD_CS0: J1.5 (CS), U1.12 (Y3)
LCD_CS1: J2.5 (CS), U1.11 (Y4)
LCD_CS2: J3.5 (CS), U1.10 (Y5)
LCD_CS3: J4.5 (CS), U1.15 (Y0)
LCD_CS4: J5.5 (CS), U1.13 (Y2)
LCD_CS5: J6.5 (CS), U1.14 (Y1)
LCD_DC: J1.6 (DC), J2.6 (DC), J3.6 (DC), J4.6 (DC), J5.6 (DC), J6.6 (DC), J7.4, U2.4 (D3)
LCD_DIN: J1.3 (DIN), J2.3 (DIN), J3.3 (DIN), J4.3 (DIN), J5.3 (DIN), J6.3 (DIN), J7.2, U2.6 (D5)
LCD_RST: J1.7 (RST), J2.7 (RST), J3.7 (RST), J4.7 (RST), J5.7 (RST), J6.7 (RST), J7.5, U2.3 (D2)

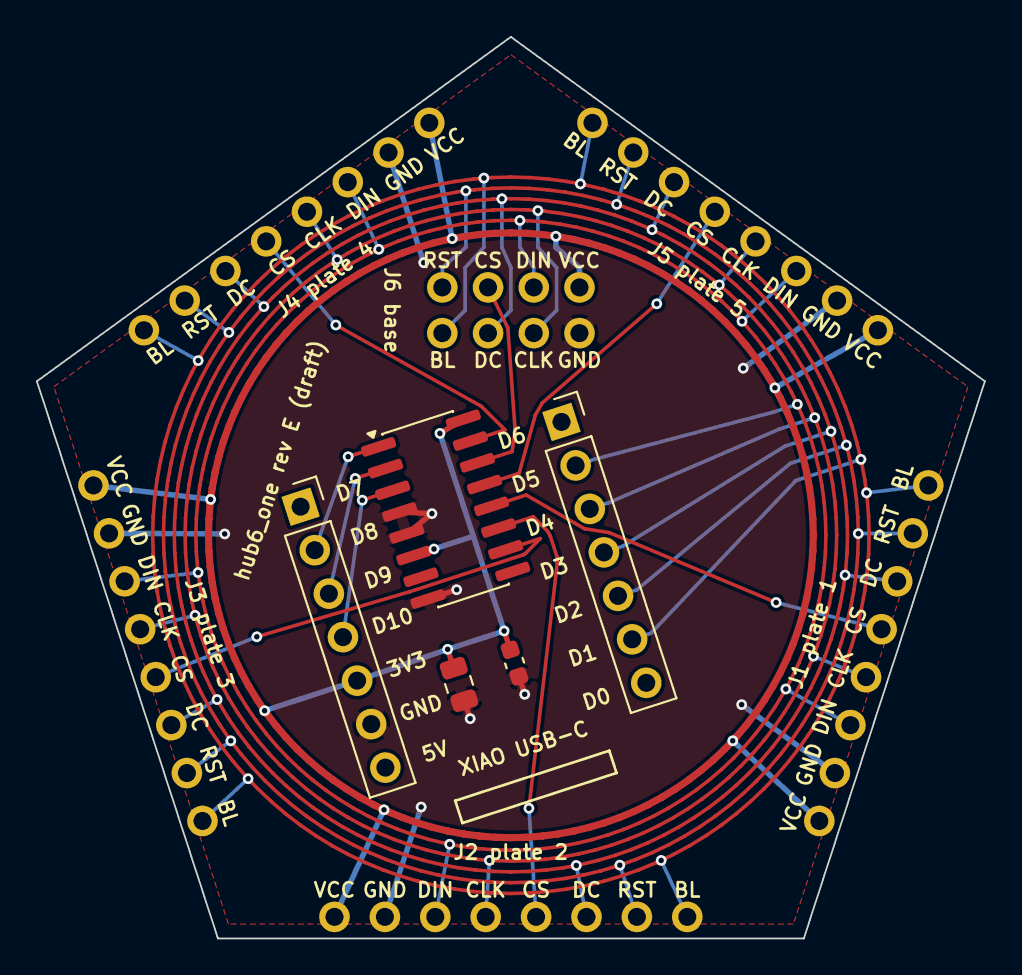
[picture p16: board hub6_one.kicad_pcb from above]

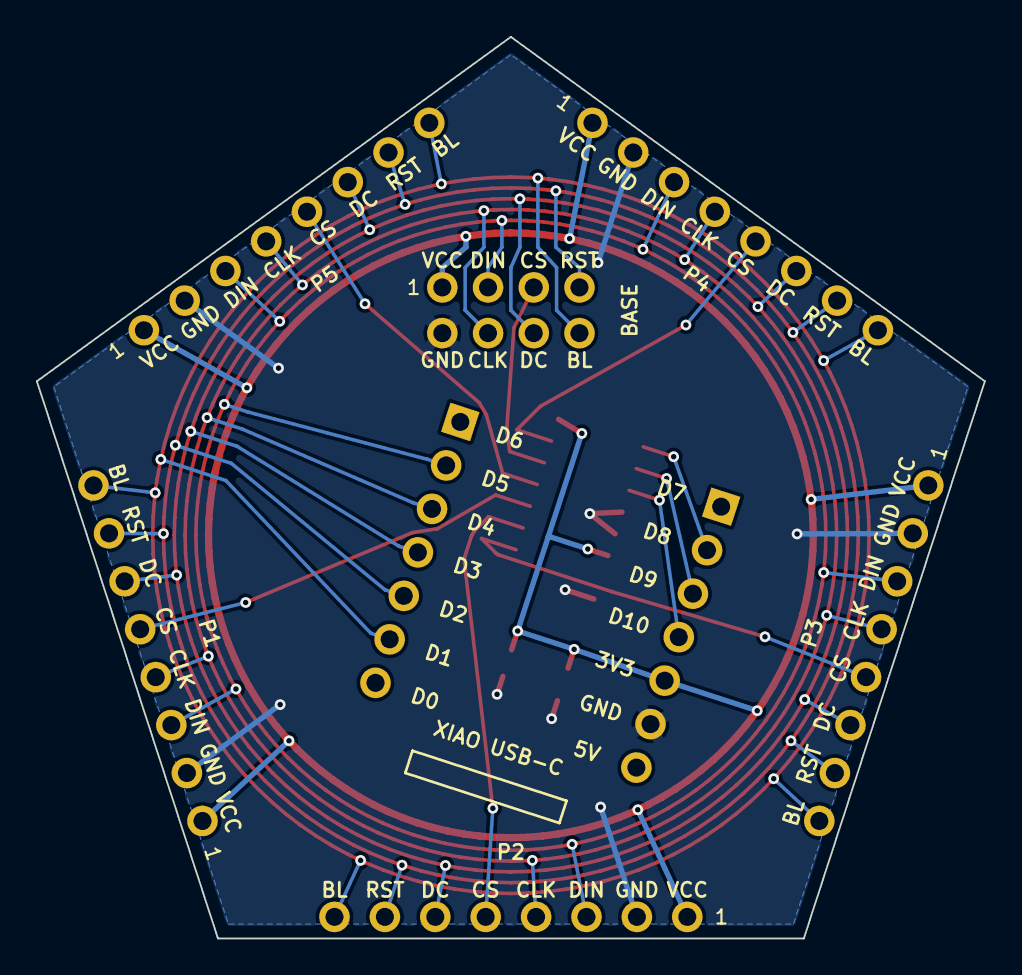
[picture p17: board hub6_one.kicad_pcb from below]

Board: 2 copper layers, 52.7 x 50.1 mm, 12 parts (7 on the bottom side), 16 nets.

Other parts of the board:
X1: XIAO; XIAO_ESP32S3_Hanging
