yuiseki/exp-dodeca-earth/hardware/hub6/hub6.kicad_pcb

## KiCad design hardware/hub6/hub6.kicad_pcb (2026-10-23)

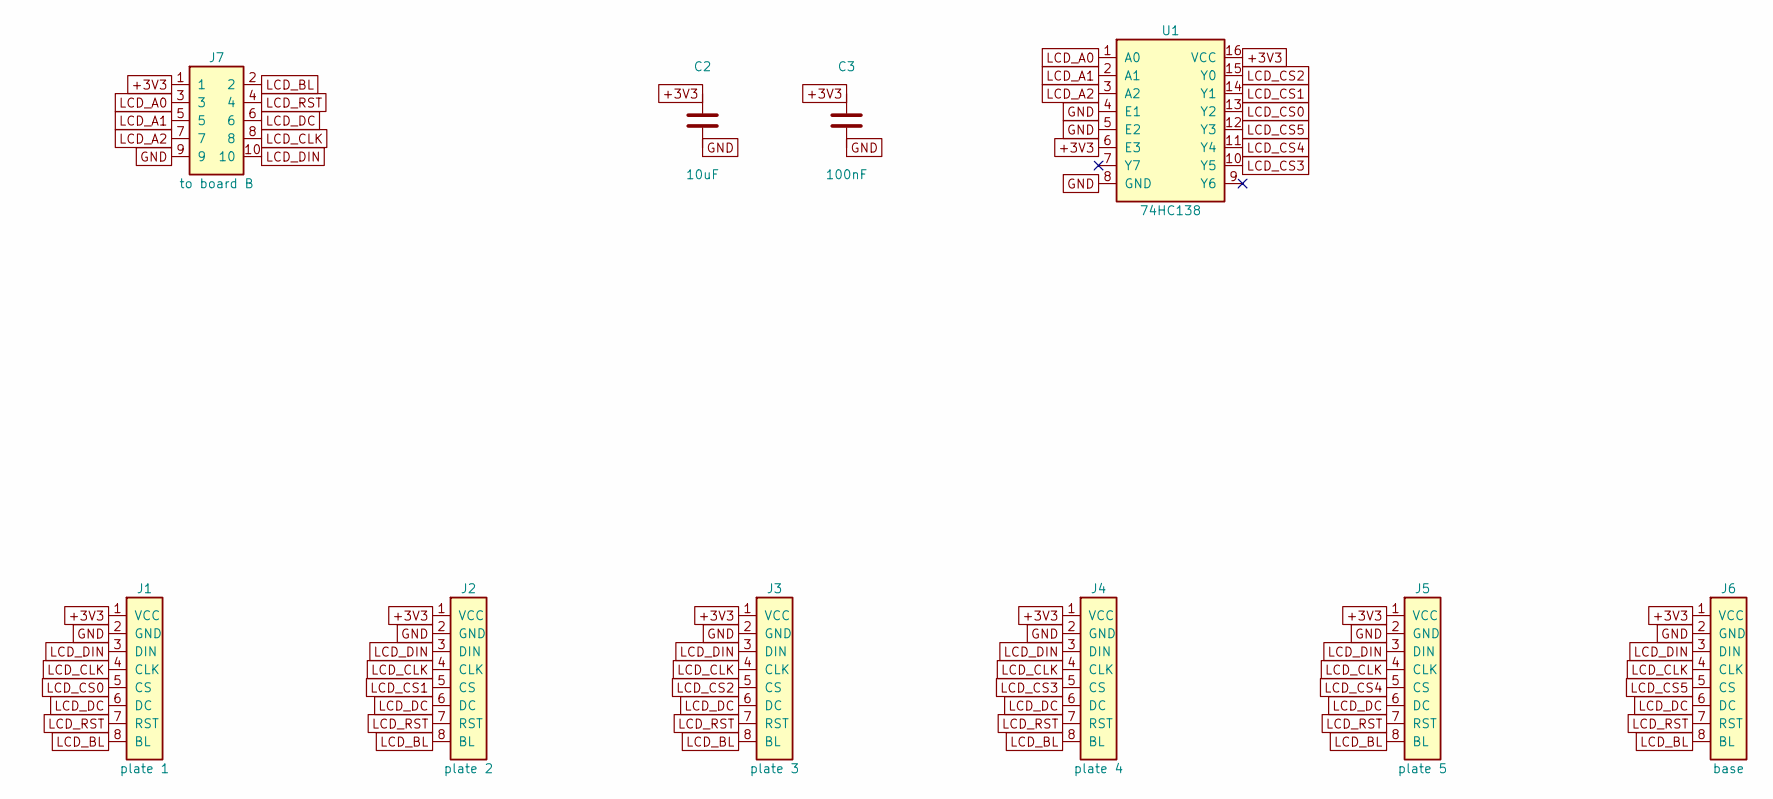
[picture p18: schematic hub6.kicad_sch, dodecahedron-earth hub6]

Parts:
C2: 10uF; C_0805_2012Metric; LCSC C15850
C3: 100nF; C_0603_1608Metric; LCSC C14663
J1: plate 1; Wire_1x08_P2.54_Tie
J2: plate 2; Wire_1x08_P2.54_Tie
J3: plate 3; Wire_1x08_P2.54_Tie
J4: plate 4; Wire_1x08_P2.54_Tie
J5: plate 5; Wire_1x08_P2.54_Tie
J6: base; Wire_2x04_P2.54
J7: to board B; PinHeader_2x05_P2.54mm_Vertical
U1: 74HC138; SOIC-16_3.9x9.9mm_P1.27mm; LCSC C5602

Connections:
+3V3: C2.1, C3.1, J1.1 (VCC), J2.1 (VCC), J3.1 (VCC), J4.1 (VCC), J5.1 (VCC), J6.1 (VCC), J7.1, U1.6 (E3), U1.16 (VCC)
GND: C2.2, C3.2, J1.2 (GND), J2.2 (GND), J3.2 (GND), J4.2 (GND), J5.2 (GND), J6.2 (GND), J7.9, U1.4 (E1), U1.5 (E2), U1.8 (GND)
LCD_A0: J7.3, U1.1 (A0)
LCD_A1: J7.5, U1.2 (A1)
LCD_A2: J7.7, U1.3 (A2)
LCD_BL: J1.8 (BL), J2.8 (BL), J3.8 (BL), J4.8 (BL), J5.8 (BL), J6.8 (BL), J7.2
LCD_CLK: J1.4 (CLK), J2.4 (CLK), J3.4 (CLK), J4.4 (CLK), J5.4 (CLK), J6.4 (CLK), J7.8
LCD_CS0: J1.5 (CS), U1.13 (Y2)
LCD_CS1: J2.5 (CS), U1.14 (Y1)
LCD_CS2: J3.5 (CS), U1.15 (Y0)
LCD_CS3: J4.5 (CS), U1.10 (Y5)
LCD_CS4: J5.5 (CS), U1.11 (Y4)
LCD_CS5: J6.5 (CS), U1.12 (Y3)
LCD_DC: J1.6 (DC), J2.6 (DC), J3.6 (DC), J4.6 (DC), J5.6 (DC), J6.6 (DC), J7.6
LCD_DIN: J1.3 (DIN), J2.3 (DIN), J3.3 (DIN), J4.3 (DIN), J5.3 (DIN), J6.3 (DIN), J7.10
LCD_RST: J1.7 (RST), J2.7 (RST), J3.7 (RST), J4.7 (RST), J5.7 (RST), J6.7 (RST), J7.4

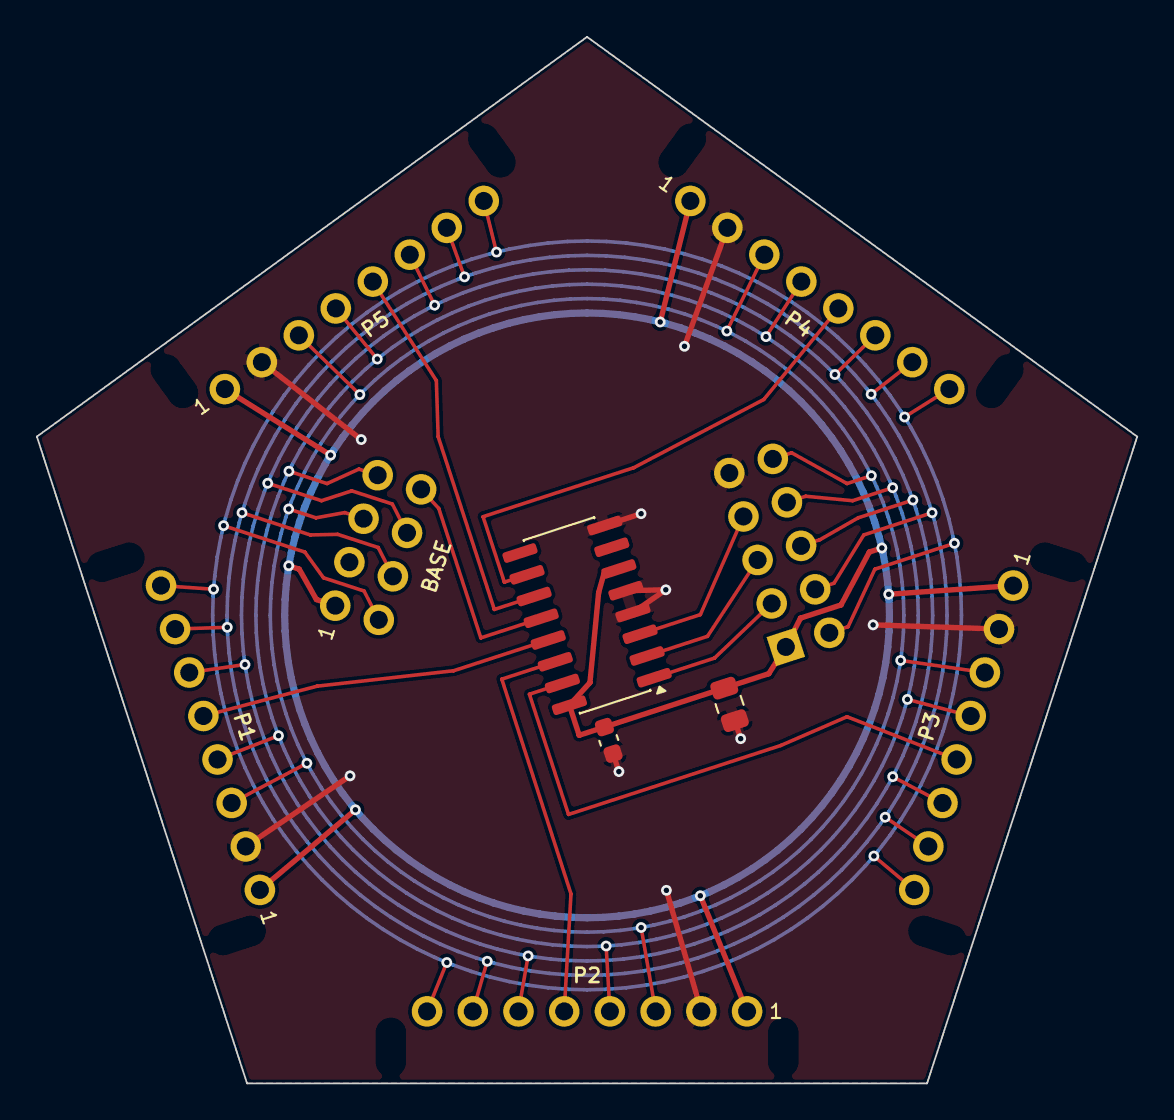
[picture p19: board hub6.kicad_pcb from above]

Board: 2 copper layers, 61.1 x 58.1 mm, 10 parts (1 on the bottom side), 16 nets.
