yuiseki/exp-dodeca-earth/(commit log)

2026-10-09 Add dodecahedron earth project scaffold
    - Pentagon LCD mounting plate v0.0.1 (STEP/STL), ordered for first print
    - 1.28inch round LCD module 3D drawing (STEP/SolidWorks), extracted from vendor zip
    Claude-Session: https://claude.ai/code/session_01WVeYczw2dnncq6csD58pZW
    [lcd_pentagon_plate.step, lcd_pentagon_plate.stl]
2026-10-09 Add simulate overlay: pentagon plate vs LCD module hole alignment
    Parses CIRCLE/CARTESIAN_POINT entities straight out of both STEP files
    (no FreeCAD/OCCT available) and overlays them in the XY plane. The two
    mounting-hole rectangles share the same 13.35x9.3mm pitch but are
    rotated 90 degrees relative to each other; rotating the display fixes
    the alignment exactly.
    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
2026-10-09 Overlay the display in the plate frame, with its connector
    The two STEP files use different frames: the plate is drawn with the
    display rotated -90 deg about Z. Mapping the display with
    (x, y) -> (y, -x) puts all four holes on the plate's holes and the
    connector housing inside the plate's slot with 0.3mm clearance, so
    v0.0.1 already fits. The earlier 0-deg overlay, which made the holes
    look swapped, compared the parts in mismatched frames.
    trace_face.py walks a face's edge loops so the PCB outline and the
    connector footprint are drawn from the real boundary, not from stray
    plane origins.
    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
2026-10-09 Add an assembled STL of the plate and the LCD module
    gmsh (which bundles OpenCASCADE) meshes the display STEP, which is then
    rotated -90 deg into the plate frame as in overlay.py. The plate sits
    flush on the PCB back face at z=0.45; the display's mounting holes are
    2.5mm brass standoffs (OD 3.5, ID 1.7) that pass through the plate's
    3.8mm holes and end 0.5mm proud of it, and the connector housing pokes
    3.6mm through the slot.
    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
2026-10-09 Add an STL of the LCD module, converted from its STEP
    step_to_stl.py meshes a STEP with gmsh in the STEP's own frame (mm,
    max edge 0.5mm). The result is closed (every edge shared by exactly two
    triangles) and spans the same box as the STEP.
    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
2026-10-09 Also write the assembly as a 3MF with per-part colours
    STL carries no colour, so overlay_stl.py now also writes overlay.3mf
    with the plate (orange) and the display (blue) as separate objects.
    Each part is checked to be closed and outward-wound before writing; the
    plate's volume matches a hand calculation (2676.6 mm3), and lib3mf
    reads back both objects with their colours.
    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
2026-10-09 Add plate v0.0.2 with the connector slot 3mm longer toward the apex
    The slot grows from y=3.5..11.5 to 3.5..14.5 (x stays +-10.3), leaving
    3.3mm in front of the connector on the apex side for plugging the cable
    in; the other sides keep 0.3mm, since the standoffs leave no room
    sideways. build.py cuts the extension out of v0.0.1 with gmsh's
    OpenCASCADE, so holes and outline are unchanged and the volume drops by
    exactly the removed 20.6 x 3 x 2mm. The STL is meshed at 72 segments
    per circle so the 3.8mm holes stay 3.796mm across the flats.
    overlay.py and overlay_stl.py now take the plate version, and overlay.py
    reads the outline and slot from the plate STEP instead of hard-coding
    them.
    Claude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
    [lcd_pentagon_plate.step, lcd_pentagon_plate.stl]
2026-10-09 Extend the v0.0.2 connector slot by 2mm instead of 3mm
    The slot now runs y=3.5..13.5, leaving 2.3mm in front of the connector
    on the apex side, and the wall at the new corners thickens from about
    1.5mm to 2.35mm.
    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
    [lcd_pentagon_plate.step, lcd_pentagon_plate.stl]
2026-10-09 Add plate v0.0.3 with sides bevelled to close a dodecahedron
    Adjacent faces of a regular dodecahedron meet at arccos(-1/sqrt(5)) =
    116.565 deg, so each side wall now lies at half that, 58.28 deg, to the
    outer face; tan(58.28 deg) is the golden ratio, so the inner face is
    inset by 2/phi = 1.236mm. The outer face (PCB side, screens out) keeps
    the 30mm edges. build.py intersects v0.0.2 with that frustum in gmsh.
    dodecahedron.py places twelve plates and displays on the faces and
    checks the fit: corners land on the vertices (8e-12mm), no part
    overlaps another, and all 30 edges touch across the full bevel
    (68.42 mm2, as calculated). The same check on the unbevelled v0.0.2
    reports 74.8 mm3 of plat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
    [lcd_pentagon_plate.step, lcd_pentagon_plate.stl]
2026-10-09 Stand the dodecahedron on a face and turn plates as two cups
    The assembly now rests on one face and reads as two six-face cups. Each
    of the ten side plates puts the edge opposite its apex, next to the
    display's flat PCB tab, on the base or top, so its connector points at
    the rim where the cups meet. The fit checks pass unchanged: any turn is
    collision-free since each display lies inside its own face's pyramid
    (0.49mm margin at worst).
    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
2026-10-09 Model the dodecahedron as two cups, joined and pulled apart
    The lower cup (base + 5) and the upper cup (top + 5) are separate parts
    coloured orange and green, written both joined and with the upper cup
    lifted 30mm. Of the 30 shared edges, 10 lie inside each cup and 10
    between the cups; the fit checks are unchanged and pass.
    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
2026-10-09 Add plates v0.0.4: magnet bosses to join the two cups
    The plate stays 2mm: thickening it as a whole makes the bevel cut into
    the upper screw holes and the slot corners (walls go negative at 4mm).
    Instead small bosses, up to 5.5mm thick, carry 3 x 1mm disc magnets in
    pockets drilled square to the bevel face on the 10 rim edges.
    Two plates sharing a rim edge meet with opposite ends, so their magnets
    can only face each other at the edge's middle - where the slot corner
    is - or at equal distances from the same end. So there are three plate
    types: lower (boss at the apex, magnets on both apex edges), upper (boss
    at each of the two corners the apex edges end in), and cap (v0.0.3's
    plate, for base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
    [lcd_pentagon_plate_cap.step, lcd_pentagon_plate_cap.stl, lcd_pentagon_plate_lower.step, lcd_pentagon_plate_lower.stl, lcd_pentagon_plate_upper.step, lcd_pentagon_plate_upper.stl, magnets.csv]
2026-10-09 Add v0.0.5: each cup of six faces as one solid, for a print quote
    The lower cup (base + 5 lower plates) and the upper cup (top + 5 upper
    plates) are the v0.0.4 plates placed on the dodecahedron and fused, so
    walls, bevels, holes, slots and magnet pockets are unchanged and only
    the joints inside a cup are gone. Volumes equal the sum of the six
    plates (15011.9 and 15341.0 mm3); the STLs are closed, 78.5 x 82.6 x
    41.3 mm, standing on the outer face and opening up.
    Placement uses gmsh's exact rotate/translate: affineTransform makes
    approximate B-spline copies and shaved 0.07% off a plate's volume.
    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
    [lcd_cup_lower.step, lcd_cup_lower.stl, lcd_cup_upper.step, lcd_cup_upper.stl]
2026-10-10 Make v0.0.5 one common cup, printed twice
    The upper cup is exactly the lower cup turned 180 deg about the x axis
    (plate placements match with matrix error 0), so one cup serves both if
    each side plate can mate either way up. On a rim edge the two plates
    meet with opposite ends, so the side plate now has a pocket at both ends
    of each rim edge: 3 bosses, 4 pockets (v0.0.4's lower apex pockets plus
    its upper corner pockets). Every pocket keeps a 0.8mm wall.
    Only 20 of the 40 pockets get a magnet, as before: cup A in its apex
    pockets, cup B (the same part) in its corner pockets. All 20 pocket pairs
    meet to 1e-11mm with antiparallel axes; the 12-plate assembly has no
    overlap and all 30 edges tou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
    [lcd_cup.step, lcd_cup.stl, lcd_cup_lower.step, lcd_cup_lower.stl, lcd_cup_upper.step, lcd_cup_upper.stl, lcd_pentagon_plate_side.step, lcd_pentagon_plate_side.stl]
2026-10-10 Put a magnet in every pocket of the common cup, one table for both
    The common cup has 40 pockets, and filling all of them gives 20 pairs
    (twice the pull) with one table for both cups. Installing both cups alike
    forces the upper pocket of each pair to be the opposite pole of the lower
    one, which leaves 10 free choices; the search takes the one whose wrong
    72 deg turns repel the most: net -4 (8 attract, 12 repel) against +20 for
    the right fit. Counted independently from magnets.csv and the pocket
    positions. 10 poles face out as N and 10 as S.
    All fit checks pass with 40 magnets (no overlap, 20 pairs aligned to
    1e-11mm and 0.4mm apart, 30 edges touching). magnets.csv is one table by
    position i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
    [magnets.csv, magnets_by_cup.csv]
2026-10-20 Add cables.py: where each cup's six display cables come out
    The five side headers sit on a ring of radius 29mm at height 29.1mm, 72
    degrees apart, long axis tangential, plugs pointing at the axis and 26.6
    degrees up; the base header is 9mm off the axis at azimuth 162 degrees,
    between plates 5 and 1, plug straight up. Cable exits (assuming a 6mm
    plug) are 27.7mm apart on the ring, and a hub on the axis at 20-26mm
    height is at most 26mm from any of them.
    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
2026-10-20 Add hardware/hub6: the board that drives one cup's six round LCDs
    One XIAO ESP32-S3 drives six 1.28 inch GC9A01 modules over one SPI bus:
    DIN, CLK, DC, RST, BL and the supply are shared, each display has its own
    chip select straight from a XIAO pin (all 11 pins used). Six PH2.0 8-pin
    through-hole headers (C157974) sit on the edges of a regular hexagon, 52mm
    across the corners, in the order the cables come out of the cup; the XIAO
    is in the middle. 4 layers (In1 GND, B.Cu +3V3, bus rings on In2),
    everything JLCPCB places is on top (Economic PCBA).
    The displays run on 3.3V, not 5V: their TXB0108 level shifter takes its
    logic levels from VCC, and at 5V it needs 3.25V for a high, which a 3.3V
    X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
    [hub6-B_Cu.gbl, hub6-B_Mask.gbs, hub6-B_Paste.gbp, hub6-B_Silkscreen.gbo, hub6-Edge_Cuts.gm1, hub6-F_Cu.gtl, hub6-F_Mask.gts, hub6-F_Paste.gtp]
2026-10-20 hub6: drop the unused SMD header footprint (the through-hole one is used)
    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
    [hub6-B_Cu.gbl, hub6-B_Mask.gbs, hub6-B_Paste.gbp, hub6-B_Silkscreen.gbo, hub6-Edge_Cuts.gm1, hub6-F_Cu.gtl, hub6-F_Mask.gts, hub6-F_Paste.gtp]
2026-10-20 hub6: add the 74HC138 back and widen the board to 25 mm to the edge
    The cup's inside (measured from lcd_cup.stl) allows a hexagon 25 mm from
    centre to edge when the board sits about 22 mm up, so the board grows from
    22.5 mm and the 74HC138 goes under the XIAO again. A0, A1, A2 take D7, D8,
    D9 and the six chip selects come from the decoder: U1's outputs run on In2
    inside radius 12.4 mm through the gaps between socket pads, then up to F.Cu
    at a lane via per header. assign.py now plans this (visibility graph on
    In2) and writes layout.json, which make.py and the README follow. D3, D6
    and D10 are free. ERC, DRC with schematic parity, and 14 tests pass.
    Claude-Session: https://claude.ai/code/sess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
    [hub6-B_Cu.gbl, hub6-B_Mask.gbs, hub6-B_Paste.gbp, hub6-B_Silkscreen.gbo, hub6-Edge_Cuts.gm1, hub6-F_Cu.gtl, hub6-F_Mask.gts, hub6-F_Paste.gtp]
2026-10-20 hub6: put the JLCPCB upload files (gerbers, BOM, CPL) in fab6
    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
    [hub6-bom.csv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]
2026-10-21 hub6: pentagon board with the display cables soldered straight in
    The board becomes a regular pentagon (26 mm to the edge) whose edges face
    the cup's five side plates one to one, instead of a hexagon whose corners
    came close to the wall. The PH2.0 headers go: the cables (PH2.0 at the
    display, bare 26 AWG wire here) are cut to length and soldered into rows
    of eight holes, so no short double-ended cable has to be bought or crimped.
    The side displays' rows run along the edges with two slots each for a
    cable tie; the base display's row runs just outside the XIAO's right
    socket row, over its plug, so its cable comes straight up from below and
    no second board is needed.
    The shared signals move to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
    [hub6-B_Cu.gbl, hub6-B_Mask.gbs, hub6-B_Paste.gbp, hub6-B_Silkscreen.gbo, hub6-Edge_Cuts.gm1, hub6-F_Cu.gtl, hub6-F_Mask.gts, hub6-F_Paste.gtp]
2026-10-21 firmware: hub6_bench, six GC9A01 through a 74HC138 on the hub6 pinout
    A breadboard test to run before ordering hub6: one XIAO ESP32-S3 drives
    six 1.28 inch round displays on one SPI bus, the chip selects from a
    74HC138, with the pins exactly as the board wires them. Each display shows
    its name, address and colour, then all six are filled in turn and the
    frames per second go to the serial port; the SPI clock can be changed
    from the serial port. The README has the wiring and what to look for.
    LovyanGFX (in M5GFX) drives the panels with no CS of its own; the first
    display gets lcd.init(), the other five only the init commands, so the
    SPI bus is set up once.
    Claude-Session: https://claude.ai/c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
2026-10-21 hub6_bench: the colours of the display's own cable
    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
2026-10-21 hub6_bench: turn all six displays 180 degrees
    Mounted in the cup they read upside down at the panel's own rotation.
    The turn is the panel's offset_rotation, so the MADCTL that both init
    paths send carries it.
    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
2026-10-21 hub6_bench: resend the address window on every display switch
    The globe showed only on P1; the others kept their names. LovyanGFX
    remembers the last CASET/RASET it sent and skips them when the next draw
    uses the same window, which is right for one panel but not for six behind
    one object: a full-screen draw on the next display went into the small
    window of the last glyph that display had drawn. select() now makes the
    panel forget its window, so every draw sends it. The names screen had
    worked only because each display started with a fill whose window
    differed from the previous display's last glyph.
    The faces are also sent a line at a time from a RAM buffer instead of
    pushImage straight from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
    [hub6_bench.ino]
2026-10-21 hub6_bench: re-initialise one display from the serial port; bench results
    "r <d>" sends one display its init sequence again and redraws it, the
    others untouched, which told a display that lost its state from one that
    never got the commands. The README records what the bench showed with six
    displays on the 23 cm Dupont leads: steady up to 20 MHz, displays going
    black or striped at 27 and 40 MHz (a waveform problem more than a supply
    one), 3.2 full frames of all six per second at 20 MHz, and no warmth to
    feel at the XIAO's regulator after ten minutes.
    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
    [hub6_bench.ino]
2026-10-21 hub6_bench: set up the SPI bus with no display selected, then init all six alike
    With P1 selected during lcd.init(), P1 came up as noise after every power-on; sending
    it the init sequence again fixed it. Now none is selected while the bus is set up, and
    all six get the same init sequence. Six of six came up on three power-ons.
    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
    [hub6_bench.ino]
2026-10-22 hub6: regenerate with the KiCad 10 footprint libraries, refresh fab6
    The KiCad libraries went from 7.0 to 10.0 today, and DRC flagged the five library
    footprints on the board (C2, C3, J7, J8, U1) as differing from the library. make.py
    loaded them again: the pads, the 757 tracks and the filled zones are the same as before
    (compared with the old board beside its own .kicad_pro); the courtyards, fab and silk
    outlines and the 3D model paths are the new ones. ERC and DRC clean, 17 tests pass,
    BOM and CPL unchanged.
    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
    [hub6-B_Cu.gbl, hub6-B_Mask.gbs, hub6-B_Paste.gbp, hub6-B_Silkscreen.gbo, hub6-Edge_Cuts.gm1, hub6-F_Cu.gtl, hub6-F_Mask.gts, hub6-F_Paste.gtp]
2026-10-23 hub6 rev C, board A: two layers, the XIAO moved to a board of its own
    With the XIAO and its sockets gone from the middle, two layers carry everything: B.Cu
    has only the rings (3V3 innermost, then the five shared signals) and GND round them;
    F.Cu has straight lines that cross the rings freely. The side rows reach the rings by
    radial stubs; J7 (a 2x5 header underneath, to board B) and the base display's holes
    (now a 2x4 block, numbered like a DIP-8, over the base plug) reach them through two
    of the pentagon's corners. The chip selects run in to the 74HC138 at the centre,
    each to the output that lets no line cross another (P1 Y2, P2 Y1, P3 Y0, P4 Y5,
    P5 Y4, base Y3). assign.py and layout.json a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
    [hub6-B_Cu.gbl, hub6-B_Mask.gbs, hub6-B_Paste.gbp, hub6-B_Silkscreen.gbo, hub6-Edge_Cuts.gm1, hub6-F_Cu.gtl, hub6-F_Mask.gts, hub6-F_Paste.gtp]
2026-10-23 Add hardware/hub6_one: a draft of one 2-layer board with the XIAO on it
    The alternative to rev C's two boards: the XIAO hangs under the middle of the pentagon on
    pin headers (flat side up, so its battery wires leave through the headers' gap), the
    74HC138 between its pin columns on top. B.Cu has the rings and, inside them, the chip
    selects, routed between the XIAO's pins (router.py, adapted from rev B's In2 router);
    F.Cu has the stubs, the XIAO's bus out through the corner at 162 degrees and the base
    display's 2x4 holes through the corner at 90. ERC, DRC and parity clean; no tests yet.
    In the v0.0.5 cup (tmp/one_in_cup.py) nothing touches: XIAO 14.0-17.5 mm, base plug top 11.6.
    Claude-Sessio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
    [hub6_one.kicad_pcb, hub6_one.kicad_sch]
2026-10-23 hub6_one: the JLCPCB upload files in fab6
    fab.py (from hub6's) writes the Gerbers and drill (2 layers), the BOM (U1, C2, C3) and
    the placement to build/fab/ and copies them to fab6/. The XIAO, its pin headers and the
    cable holes are soldered by hand and stay out of the BOM and CPL.
    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
    [hub6_one-B_Cu.gbl, hub6_one-B_Mask.gbs, hub6_one-B_Paste.gbp, hub6_one-B_Silkscreen.gbo, hub6_one-Edge_Cuts.gm1, hub6_one-F_Cu.gtl, hub6_one-F_Mask.gts, hub6_one-F_Paste.gtp]
2026-10-23 hub6_one: the XIAO in two female sockets under the board, parts as hub3's
    The XIAO now plugs into two 1x7 8.5 mm female sockets (C2832270) on the underside,
    3 mm off the middle toward 342 degrees so that, hanging lower, it clears the base
    display's plug: with the connectors as they are (top entry, 3 mm proud of the plate,
    the plug 2 mm more; tmp/connectors.py) nothing touches, 1.5 mm to the nearest. Plate 3's
    chip select goes round the chip's USB-C end now (Y0); P1 Y2, P2 Y1, P3 Y0, P4 Y5, P5 Y3,
    base Y4. U1 is C2674688, as on cubic-earth's hub3 (the capacitors and sockets were
    already the same). fab.py writes the sockets as bottom-side parts. ERC, DRC, parity clean.
    Claude-Session: https:/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
    [hub6_one-B_Cu.gbl, hub6_one-B_Mask.gbs, hub6_one-B_Paste.gbp, hub6_one-B_Silkscreen.gbo, hub6_one-Edge_Cuts.gm1, hub6_one-F_Cu.gtl, hub6_one-F_Mask.gts, hub6_one-F_Paste.gtp]
2026-10-23 hub6_one: the XIAO's sockets are soldered by hand, out of the BOM and CPL
    J7 and J8 keep their footprints (the same C2832270 as hub3's, noted in fab6/README.md for
    buying) and are excluded from the BOM and the placement file: JLCPCB places only U1, C2
    and C3, all on top. ERC, DRC, parity clean.
    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
    [hub6_one-B_Cu.gbl, hub6_one-B_Mask.gbs, hub6_one-B_Paste.gbp, hub6_one-B_Silkscreen.gbo, hub6_one-Edge_Cuts.gm1, hub6_one-F_Cu.gtl, hub6_one-F_Mask.gts, hub6_one-F_Paste.gtp]
2026-10-23 hub6_one: each cable hole's signal on the silkscreen, both sides
    VCC, GND, DIN, CLK, CS, DC, RST, BL beside every hole of the six cable rows: just outside
    each side row's holes, reading outward, and outward of J6's outer row and inward of its
    inner row; on the top and the bottom, since the side cables come from above and the base
    cable from below. A wire in the wrong hole is the easy mistake. DRC clean; fab6 rebuilt.
    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
    [hub6_one-B_Cu.gbl, hub6_one-B_Mask.gbs, hub6_one-B_Paste.gbp, hub6_one-B_Silkscreen.gbo, hub6_one-Edge_Cuts.gm1, hub6_one-F_Cu.gtl, hub6_one-F_Mask.gts, hub6_one-F_Paste.gtp]
2026-10-23 hub6_one: the XIAO's pin names and its USB-C end on the silkscreen
    Two 1x7 sockets take the XIAO turned round as well, so both sides now show each socket
    pin's name (D0..D6; 5V, GND, 3V3, D10..D7) between the sockets, and an outline of the
    USB-C with "XIAO USB-C" beyond the end it goes. Seen from below, as it is plugged in, the
    names read as Seeed's front pinout turned round. C2 moves 1.2 mm inward, clear of a name.
    DRC clean; fab6 rebuilt.
    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
    [hub6_one-B_Cu.gbl, hub6_one-B_Mask.gbs, hub6_one-B_Paste.gbp, hub6_one-B_Silkscreen.gbo, hub6_one-Edge_Cuts.gm1, hub6_one-F_Cu.gtl, hub6_one-F_Mask.gts, hub6_one-F_Paste.gtp]
2026-10-28 hub6_bench: build for the hub6_one board by default, the breadboard with HUB6_BREADBOARD
    hub6_one wires DIN D5, CLK D4, DC D3, RST D2, BL D1, A0..A2 on D10, D9, D8,
    and its chip selects P1..BASE on Y2, Y1, Y0, Y5, Y3, Y4.
    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
2026-10-28 hub6_bench: boot into the identity screen and stay there; the earth only on 'e'
    While the board is being assembled, the names show which display is which.
    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
2026-11-05 Place each display on the plate it really sits on (hub6_one mirrors the rows)
    hub6_one is used flipped, XIAO toward the cup's opening, so its cable rows reach
    the plates in mirror order: seen from outside the base, P1..P5 run counter-
    clockwise and the base display's up points at P2 (bench, 2026-11-05).
    make_earth_faces.py gets --board hub6_one (default) | model and a PLACEMENT table.
    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
    [make_earth_faces.py, test_make_earth_faces.py]
2026-11-05 hub6_bench: log the AP's scan rssi and each wifi disconnect reason
    A cup that never joined pi5-w-1 printed only 'no AP joined'; these lines showed
    reason 2 (auth expire) over and over and a scan of 2 to 4 APs where the bridge
    sees 18.
    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
2026-11-05 hub6_bench: README notes the U.FL antenna and what its absence looks like
    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
2026-11-07 hub6_bench: add c to test the Sense expansion board's microSD
    D8/D9/D10 are the 74HC138's address lines here and the card's SPI there, so the
    pins are switched to SPI on SPI3 only while the card is used and handed back.
    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
2026-11-07 hub6_one rev E (draft): edge 22.4 mm, no tie slots, rings and rows tightened, pin names inside the rows
    Rev D's 26 mm edge came from two cable-tie slots per edge and pin names set
    outward; without them the rows move in to 21.2 mm and the rings pack 0.6-0.7 mm
    apart (0.55 breaks the 0.15 clearance at the vias). The cup's wall narrows 0.5 mm
    per mm of depth, so the board sinks 7.2 mm, for a Sense expansion board
    (4.3 mm above a plain XIAO's top, 9.5 mm with the camera). ERC, DRC and schematic
    parity are clean. fab6 still holds rev D, the board that was ordered.
    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
    [hub6_one.kicad_pcb, hub6_one.kicad_sch]
2026-11-07 hub6_one rev E (draft): widen the side rows' hole pitch from 2.54 to 2.8 mm
    3.0 mm and more make a hole's stub and via touch its neighbour's (clearance and
    short errors); 2.8 is clean in ERC, DRC and schematic parity.
    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
    [hub6_one.kicad_pcb, hub6_one.kicad_sch]
2026-11-07 hub6_one rev E (draft): sockets on the top side, 5.0 mm, placed by JLCPCB
    The board is drawn for the XIAO hanging under it and then turned over (flip_board):
    the XIAO plugs from F into two Hong Cheng HC-PM254-5.0H-1x7PZ sockets (C27985232,
    3.5 mm lower than hub3's 8.5 mm part, same square holes and 1.02 mm drills), and U1,
    C2 and C3 end up on B. The rows' holes take no fill connection (spokes ran into
    slivers once flipped). fab6 now holds rev E; rev D is in e105b53. ERC, DRC and
    schematic parity are clean. Bottom-side CPL rotation is not yet checked at JLCPCB.
    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
    [hub6_one-B_Cu.gbl, hub6_one-B_Mask.gbs, hub6_one-B_Paste.gbp, hub6_one-B_Silkscreen.gbo, hub6_one-Edge_Cuts.gm1, hub6_one-F_Cu.gtl, hub6_one-F_Mask.gts, hub6_one-F_Paste.gtp]
2026-11-07 hub6_one rev E (draft): U1, C2 and C3 on the top side with the sockets
    JLCPCB's Economic PCBA places one side only, and the previous rev E draft put U1,
    C2 and C3 on the bottom. They are now drawn on B before the flip (ON_B), so they end
    up on F between the sockets, under the XIAO. Turned over, U1's pins run the other
    way: A0..A2 come from D8, D9, D10 and each display takes the output that sits where
    its rev D output did (CS_OUTPUT). U1's longer lines stay on F.Cu and drop to its
    pads through vias; the router takes the pads and stubs on B.Cu as polygon
    obstacles, every output's stub included. ERC, DRC and schematic parity are clean.
    The firmware gets a HUB6_ONE_REV_E build with the new A0..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
    [hub6_one-B_Cu.gbl, hub6_one-B_Mask.gbs, hub6_one-B_Paste.gbp, hub6_one-B_Silkscreen.gbo, hub6_one-Edge_Cuts.gm1, hub6_one-F_Cu.gtl, hub6_one-F_Mask.gts, hub6_one-F_Paste.gtp]
2026-11-07 hub6_one fab6: note that OSP rules out Economic PCBA; use lead-free HASL
    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
2026-11-07 hub6_one rev E (draft): number J6 zigzag so the base cable goes in in order
    Rev D numbered the base display's 2x4 holes like a DIP-8, which put the cable's two
    ends (VCC and BL) side by side and twisted the wires. Odd pins now run along the
    outer row and even ones along the inner row, 1 and 8 at opposite corners. The inner
    row's lines all take the gap on the same side (inside the block), and J6's pin names
    lie along the rows. ERC, DRC and schematic parity are clean.
    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
    [hub6_one-B_Cu.gbl, hub6_one-B_Mask.gbs, hub6_one-B_Paste.gbp, hub6_one-B_Silkscreen.gbo, hub6_one-Edge_Cuts.gm1, hub6_one-F_Cu.gtl, hub6_one-F_Mask.gts, hub6_one-F_Paste.gtp]
2026-11-07 Constraints for shrinking the cup, and the 3D fit of the display modules
    constrains.md gathers what limits the cup's size: the module's outline and
    heights (from Waveshare's STL), the dodecahedron's geometry, the plates' bevel and
    magnet bosses, the hub board and XIAO inside, and the looks. simulate/module_fit
    places a module on all twelve faces and finds the smallest edge with no two
    neighbours closer than 0.3 mm: 30.00 mm with the modules' bump toward the pole
    (as now), 28.75 mm toward the equator; sinking them 1.6 mm into the plates needs
    30.25 to 31.00 mm, raising them 2 or 4 mm more allows 27.75 or 26.75 mm.
    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
2026-11-07 Sweep every way the modules can sit: side bump angle, base bump, height
    320 combinations, smallest edge each to 0.125 mm. At today's height the side
    bumps toward the rim vertex and the base bump toward a vertex give 28.28 mm;
    raising the modules shrinks it to about 26.3 mm, where the screw holes leave the
    plate; sinking them needs 29.7 mm or more. Results summarised in constrains.md,
    pictures and tables in tmp/simulate (not in git).
    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
2026-11-07 sweep: a contain option, modules inside their own face; the cup cannot shrink then
    With every module's outline kept inside its face's pentagon, all 320 combinations
    are limited by that alone, at 29.97 to 30.44 mm: today's 30 mm cup is about as
    small as it gets without overhang.
    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
2026-11-07 Exempting or dropping the pole displays does not shrink the cup either
    With only the side modules kept inside their faces, the smallest edge is 29.41 to
    29.88 mm: the side faces themselves are the limit.
    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
2026-11-07 Round parts inside their faces, bumps free: 27.62 mm at 2 mm up
    With only each module's round part kept inside its face and the bumps allowed to
    overhang (toward the equator on the sides, toward a vertex on the poles), the cup
    shrinks to 28.56 mm at today's height and 27.62 mm from 2 mm up, where the round
    part itself is the limit. Keeping the pole bumps inside holds it at 30 mm.
    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
2026-11-07 v0.0.6-a and -b cups: bumps toward the vertices, only the round parts inside the faces
    v0.0.6/build.py builds plates around each module, its bump toward the apex (the
    equator on the side plates, a vertex on the poles) and its connector slot on the
    other side, adds v0.0.4's magnet bosses with the magnets 4.0 mm from their
    vertex (at 5.0 mm a corner pocket came within 0.05 mm of a standoff hole), drills
    the standoff holes again through the corner bosses, and fuses the cup as v0.0.5.
    a: edge 27.625 mm, the modules 2 mm up on rings; b: edge 28.5625 mm, on the plate
    as now. Cups 13.8 and 14.1 cm3 (v0.0.5: 15.9), closed meshes.
    Claude-Session: https://claude.ai/code/session_01WVeYczw2dnncq6csD58p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
    [lcd_cup.step, lcd_cup.stl, lcd_pentagon_plate_pole.step, lcd_pentagon_plate_pole.stl, lcd_pentagon_plate_side.step, lcd_pentagon_plate_side.stl, lcd_pentagon_plate_side_plain.step, lcd_pentagon_plate_side_plain.stl]
2026-11-07 simulate: v0.0.6-a and -b assembled with their displays
    v0_0_6.py runs dodecahedron.py with the v0.0.6 plates: the displays turned so
    their bump points at the apex, the module at the plate's origin, the pole plates'
    own centre, and variant a's modules 2 mm up. Both pass: no overlap between plates,
    displays and magnets, plate corners on the vertices, every edge in contact, and
    one magnet table serving both cups (+20 for the right fit, -4 at each wrong turn).
    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
    [magnets.csv]
